demircitaks/proxys/measuring-cup/TOZ-MINI.md

# Mini toz kepçesi — 15 mL / 30 mL

Üç parça, pim yok, O-ring yok, ray yok. Hepsi desteksiz basılır.

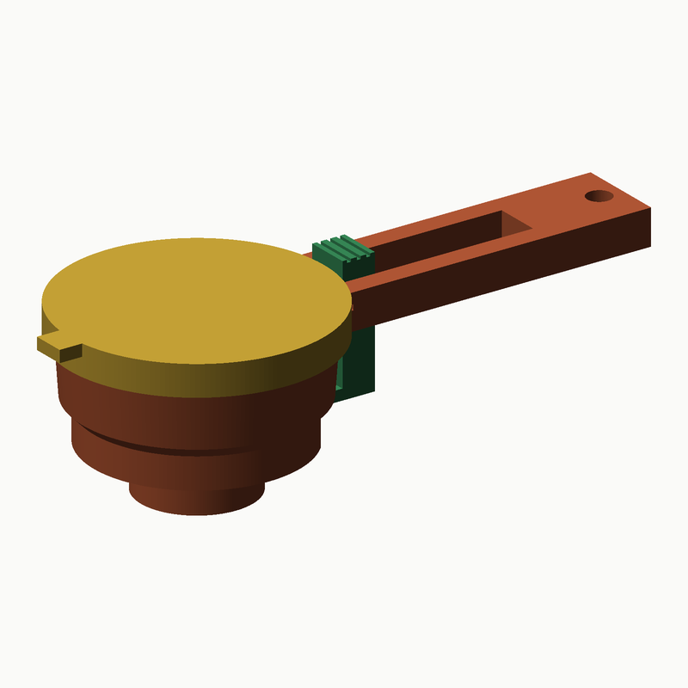
[picture p3: measuring-cup/docs/mini-kepce.png]
Kepçe


| Parça | Ne yapar |
|---|---|
| **Hazne** | Yuvarlak; üst kısmı 7° konik, altta **45° huni**, en altta **Ø22 açıklık = tabanın tamamı** (düz taban yok). 15 mL için 15,7 mm, 30 mL için 26,9 mm derin (huni hacim aldığı için). Dışı altta 45° pahlı (hafif huni görünümü). Açıklık, haznenin altındaki ince taban levhasının (alt deri + **sürgü kanalı** + üst deri) içinden geçer ve 45° koniyle **Ø20,6 × 8 mm boruya** iner: boru 500 mL PET su şişesinin boynuna (PCO-1881 iç Ø21,74; hafif 26/22 boyun ~21,4) 0,4–0,6 mm boşlukla **girer**, toz dışarı dökülmez. **Sap ağız hizasında**, cidara bağlı; 58 mm, asma delikli; kökünde sürgü ayağının geçtiği çatal yarığı. |
| **Sürgü** (taban plakası) | Kanalda kayan **deliksiz** plaka + arkaya uzanan kol + haznenin dışında dik yükselen **ayak** + sapın üstünde tırtıklı **başparmak sürgüsü**. Kapalıyken plaka açıklığın altında, yay parmakları kanal duvarındaki yuvaya oturur (klik); sürgüyü **29 mm kendine çek** → açıklık tamamen açılır, ayak çatalın sonuna dayanır; ileri it → klik, kapalı. Ayak boyu hazneye göre (15/30 ayrı). |
| **Üst kapak** | Ağza klik diye geçen düz kapak, kulaklı; eteği sap hizasında kesik (klik 320°'de). |

**Kullanım:** üst kapağı çıkar → daldır, sıyır → kapağı tak. Dökerken: kepçeyi
şişe ağzına oturt (havşa ağzı ortalar), sapı tutan elin başparmağıyla sürgüyü
kendine çek, hafifçe tıklat, sürgüyü ileri it.

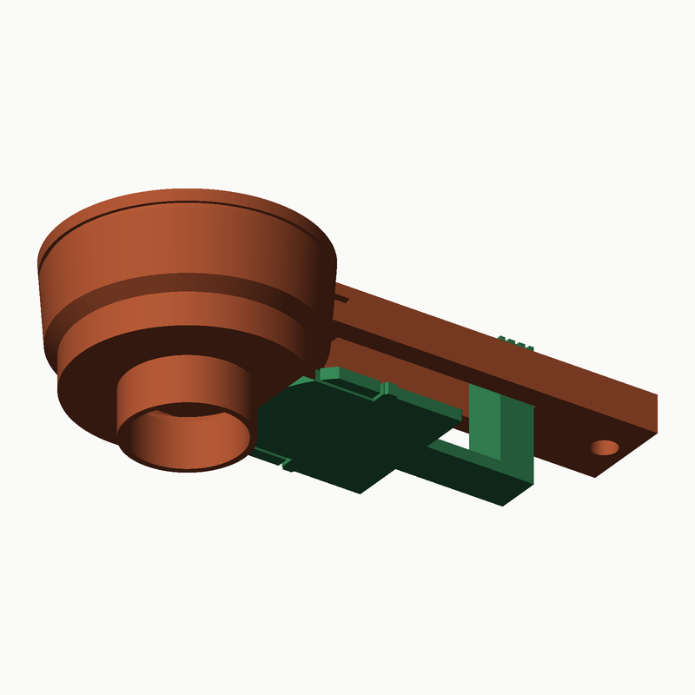
[picture p4: measuring-cup/docs/mini-acik-alt.png]
Açık, alttan


## Ölçülen

| | 15 mL | 30 mL |
|---|---|---|
| Sürgü 0–29 mm kayarken hazneyle girişim (tümseksiz) | 0,000 mm³ | 0,000 mm³ |
| Yay parmağı tümseklerinin kanal duvarına binmesi (arada, esneme 0,35 mm) | 2,41 mm³ | 2,41 mm³ |
| Kapalı / açık konumda, üst kapak takılı, kapak–sürgü | 0 / 0 / 0 / 0 | 0 / 0 / 0 / 0 |
| Kapalıyken açıklık plaka ile tam örtülü; açıkken plaka açıklığın üstünde değil | evet / evet | evet / evet |
| İç hacim (ağza kadar, mesh) | 14,997 mL | 29,992 mL |
| Silme hacim | 15,0000 mL | 30,0000 mL |

## Parçalar ve baskı

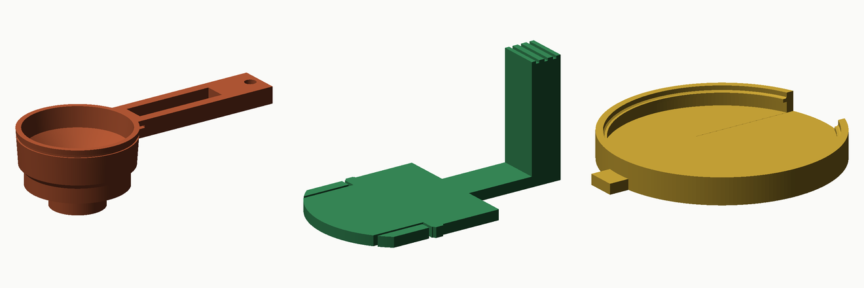
[picture p5: measuring-cup/docs/mini-parcalar.png]
Parçalar


`stl/toz-mini/` dosyaları **model yönünde** (sap üstte, kullanıldığı gibi).
`stl/toz-mini/baski/` aynı parçalar **baskı yönünde** (çevrilmiş) — dilimleyiciye
doğrudan bunları atabilirsin.

| Dosya | Baskı yönü |
|---|---|
| `01-hazne-15ml.stl` · `01-hazne-30ml.stl` | 180° çevir: **ağız tablada**, sap tablada, huni yukarı. İç huni ve dış pah 45° → destek yok |
| `02-surgu-15ml.stl` · `-30ml.stl` | Olduğu gibi: plaka tablada, ayak dik yukarı |
| `03-ust-kapak-15ml.stl` · `-30ml.stl` | 180° çevir: dış yüzü tablada, etek yukarı |

PETG · 0,16 mm · 3 duvar · %15 dolgu · destek kapalı. Tek köprü: haznenin iç
tabanı sürgü kanalının üstünde 28 mm köprülenir (X1C için sorun değil).
Ayrıntı: `BASKI-KILAVUZU.pdf`. Sürgü sıkıysa `FIT` 0,30 → 0,40; klik zayıfsa
`BUMP` 0,5 → 0,6; huni daha dik istenirse `FUN_A` 45 → 55 (`cad/scoop_mini.py`).

## Hazır baskı dosyaları (Bambu Lab X1C)

`x1c/` klasörü:

| Dosya | Ne için |
|---|---|
| `kepce-15ml-X1C.gcode.3mf` · `kepce-30ml-X1C.gcode.3mf` | **Dilimlenmiş**, doğrudan basılır. USB belleğe at → yazıcı ekranında seç → bas. Ya da Bambu Studio'da *Dosya → İçe aktar* ile aç ve Wi-Fi/bulut üzerinden gönder. |
| `kepce-15ml-proje.3mf` · `kepce-30ml-proje.3mf` | Dilimlenmemiş **proje**: Bambu Studio / OrcaSlicer'da aç, istersen ayarları değiştir, dilimle, gönder. |
| `profil/` | Kullanılan X1C profilleri (0,4 nozul; 0,16 mm; Bambu PETG HF; 3 duvar; %15 gyroid; destek kapalı; brim yok; **Textured PEI tabla 70 °C**, nozul 245 °C). |

Tek plakada hazne + sürgü + üst kapak: 15 mL ≈ **57 dk, 21,5 g**; 30 mL ≈ **70 dk, 26,8 g**.
Yazıcıda *Textured PEI* plaka takılı olmalı; filament AMS'te PETG (HF) olarak tanımlı
olmalı. Yeniden üretim: `cad/slice_x1c.sh` (OrcaSlicer CLI).

## Montaj

1. Sürgünün ayağını sapın kökündeki çatal yarığına üstten sokun, plakayı
   haznenin altındaki kanala arkadan sürüp öne itin; sonunda klik (kapalı).
2. Sürgüyü geri çekin: ayak çatalın sonuna dayanınca açıklık tamamen açık.
   Üst kapağı bastırın (eteğin kesik tarafı sapa gelir).
3. Temizlik: sürgüyü arkaya çekip ayağı çataldan yukarı çıkarın.

## Notlar

- Hacim ölçer, gram değil: 15 mL ≈ 5–8 g, 30 mL ≈ 10–17 g. Bir kez tartın.
- Açıklık Ø22, huni 45°, boru içi Ø18,4: toz kendi ağırlığıyla akar, gerekirse
  tıklatın. Düz taban olmadığı için köşede toz kalmaz.
- Boru altta 8 mm çıkıntı yaptığı için kepçe masaya düz oturmaz; kutunun
  içinde veya kapağının üstünde durur. Boru sığmayan (iç çapı < 20,8) boyun
  görürsen `SPOUT_OD` 20,6 → 20,0.
- Plaka ile üst deri arası düz-düz temas (0,3 mm boşluk); toz için yeterli,
  sıvı için değil. Kapalıyken plakada delik yok: çantada dökülmez.
- FDM gıda sertifikasız; elde yıkayın.

`python3 cad/build_mini.py` → STL (`stl/toz-mini/`), rapor, görseller.
