demircitaks/proxys/measuring-cup/docs/kesit-15ml.png

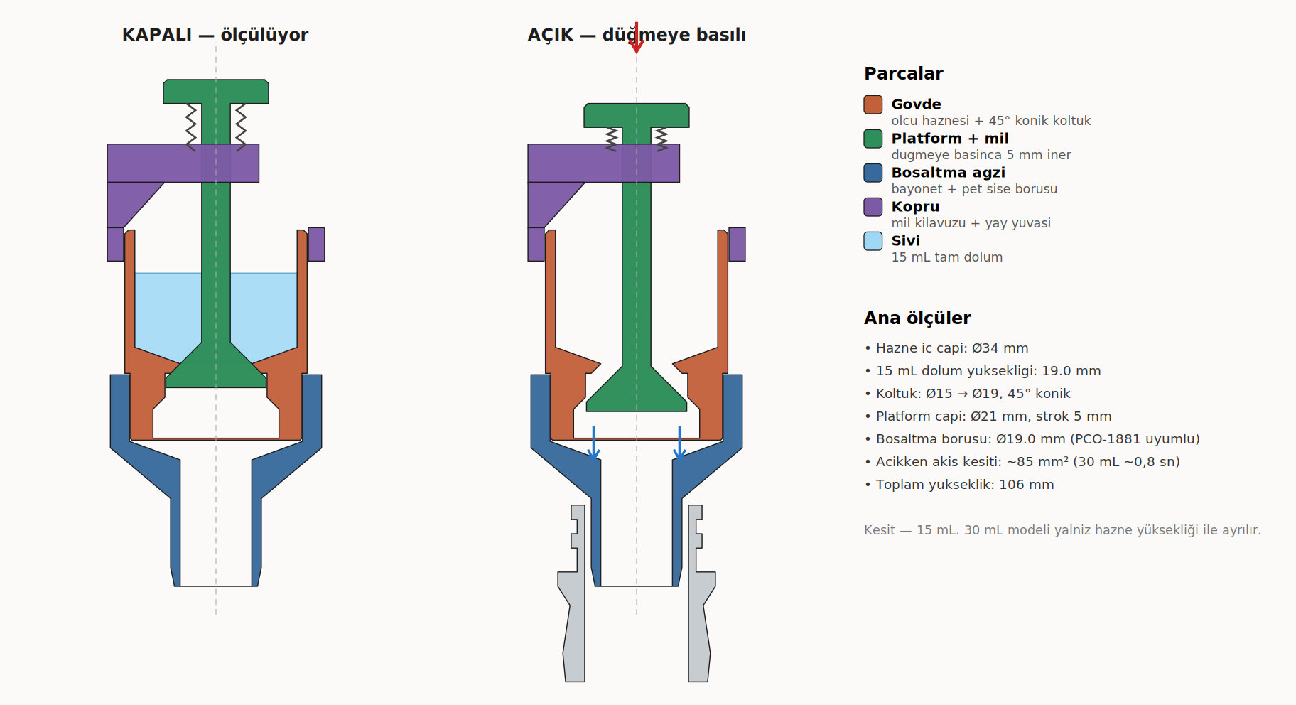
measuring-cup/docs/kesit-15ml.png
