demircitaks/proxys/measuring-cup/docs/kesit-30ml.png

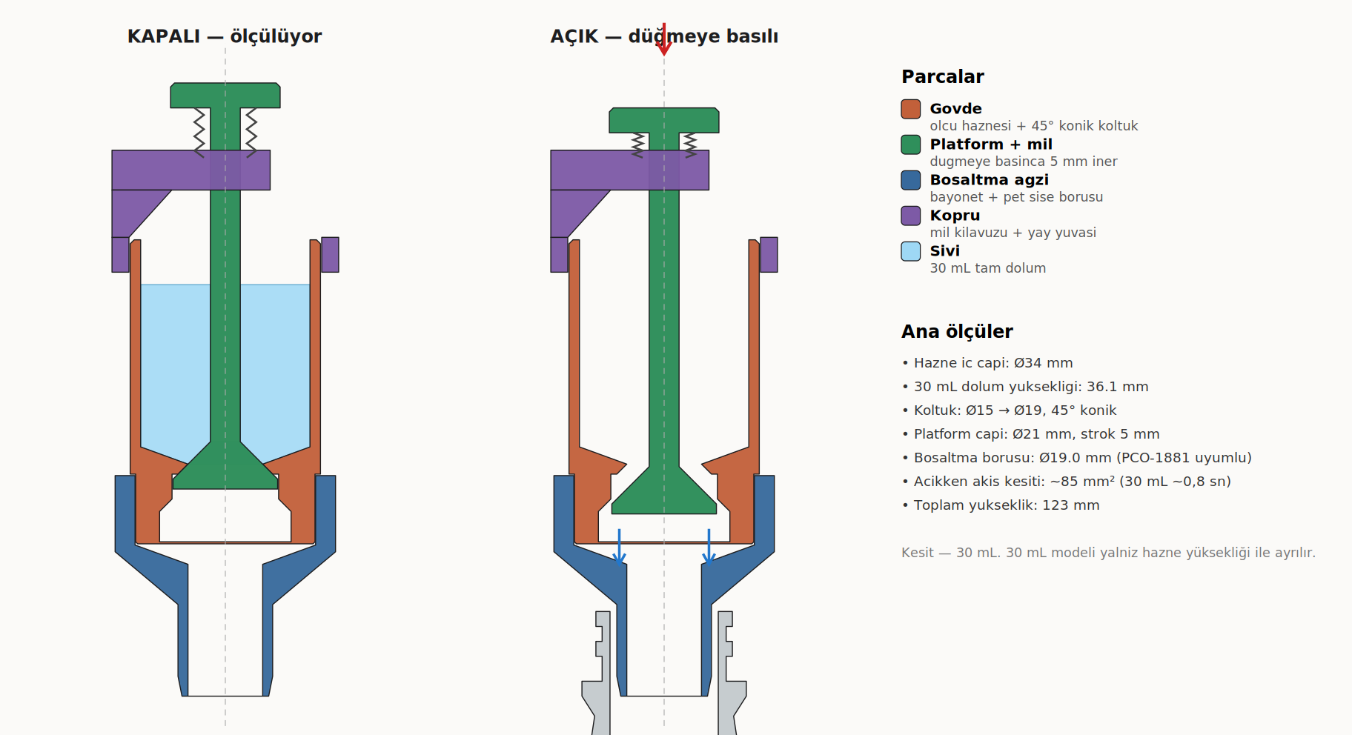
measuring-cup/docs/kesit-30ml.png
