demircitaks/proxys/measuring-cup/docs/mini-15ml-acik.png

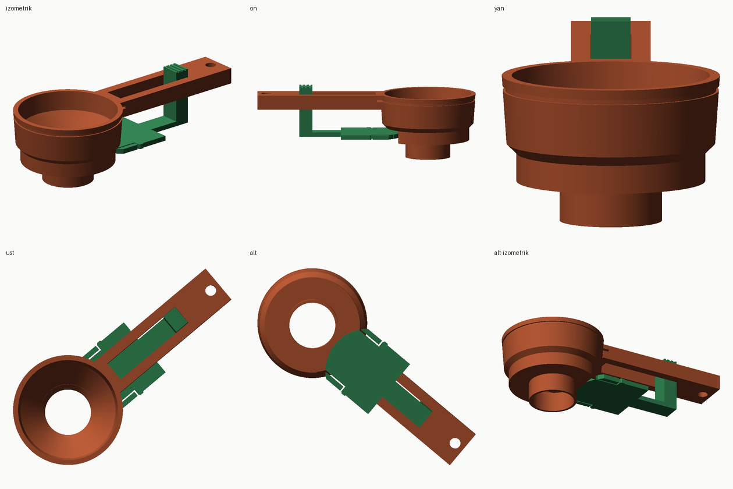
measuring-cup/docs/mini-15ml-acik.png
