demircitaks/proxys/measuring-cup/docs/mini-kesit.png

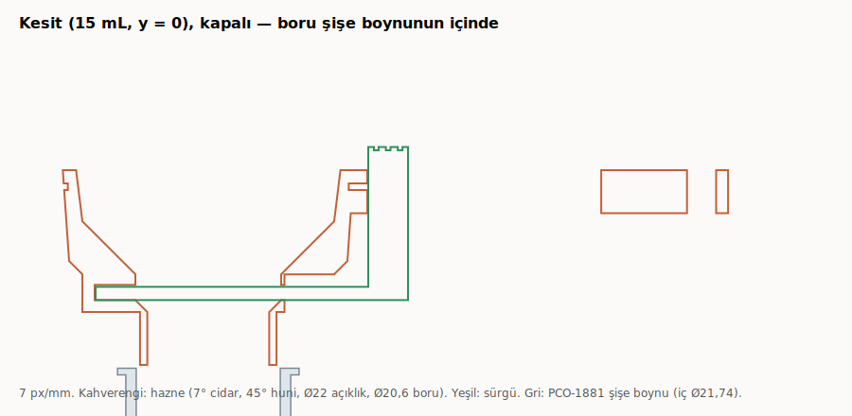
measuring-cup/docs/mini-kesit.png
