demircitaks/proxys/measuring-cup/docs/sade-15ml-acik.png

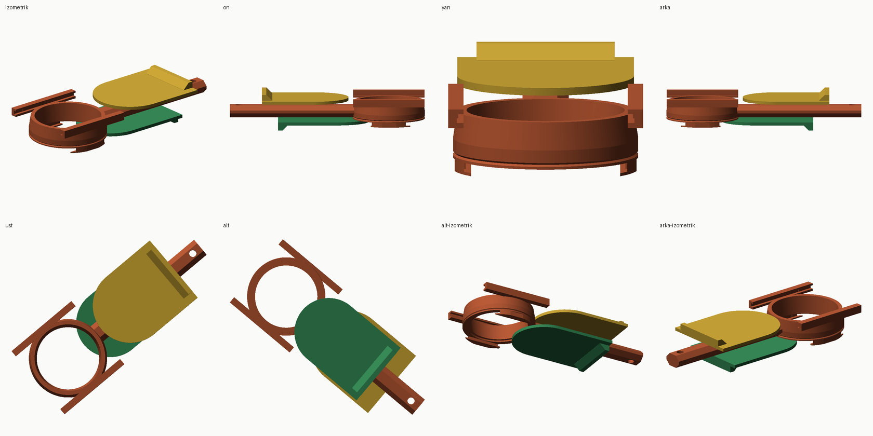
measuring-cup/docs/sade-15ml-acik.png
