demircitaks/proxys/measuring-cup/docs/sade-15ml-kapali.png

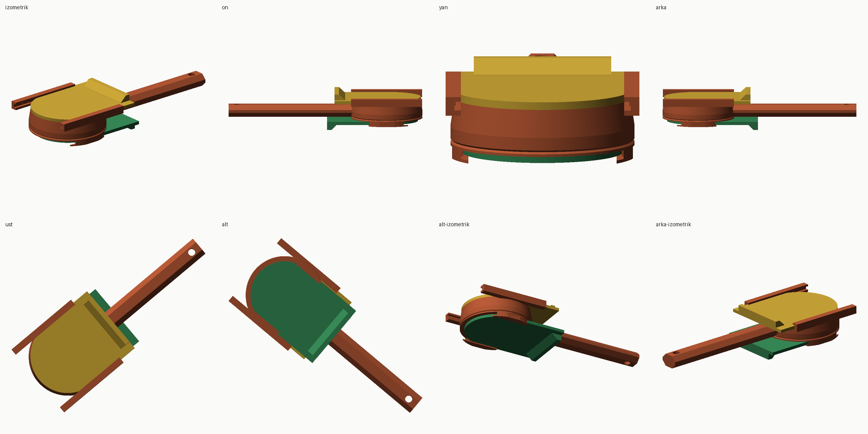
measuring-cup/docs/sade-15ml-kapali.png
