demircitaks/proxys/measuring-cup/docs/sade-30ml-kapali.png

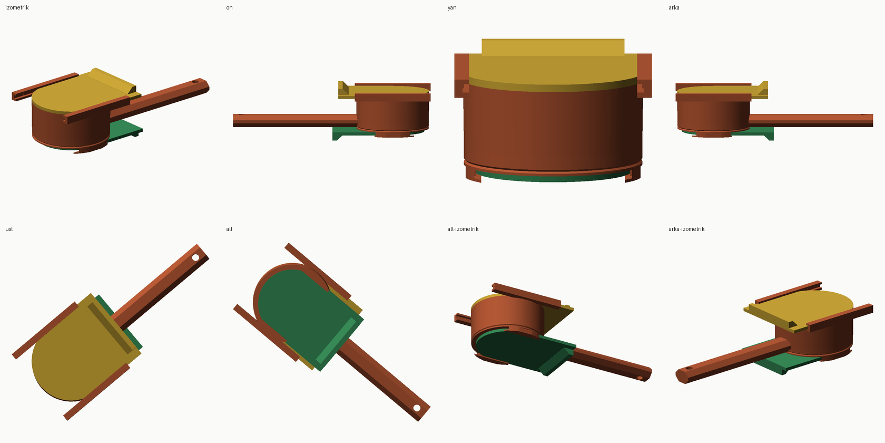
measuring-cup/docs/sade-30ml-kapali.png
