demircitaks/proxys/measuring-cup/docs/surgulu-15ml-acik.png

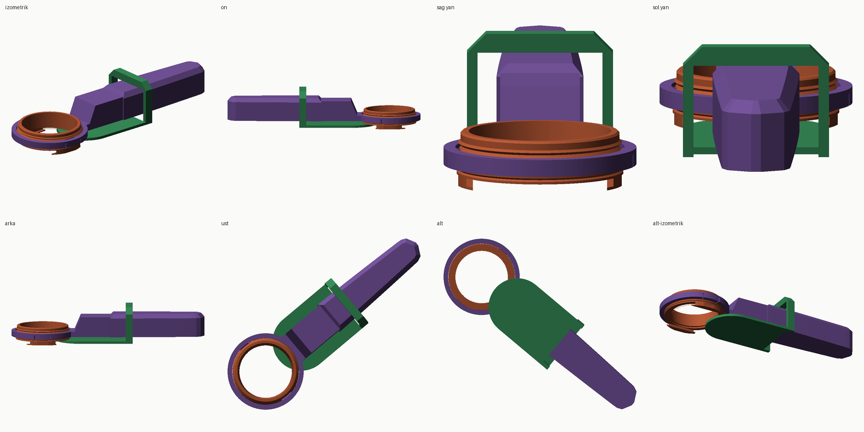
measuring-cup/docs/surgulu-15ml-acik.png
