demircitaks/proxys/measuring-cup/docs/surgulu-huni.png

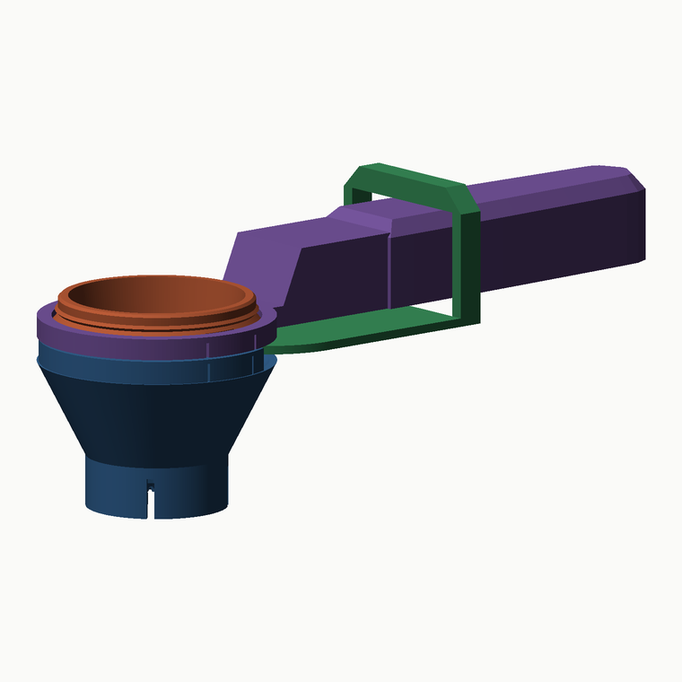
measuring-cup/docs/surgulu-huni.png
