demircitaks/proxys/measuring-cup/docs/surgulu-oring.png

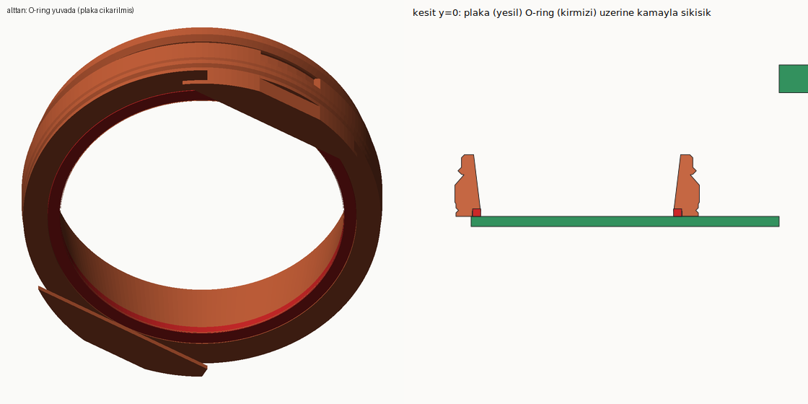
measuring-cup/docs/surgulu-oring.png
