demircitaks/proxys/measuring-cup/docs/toz-kesit-15ml.png

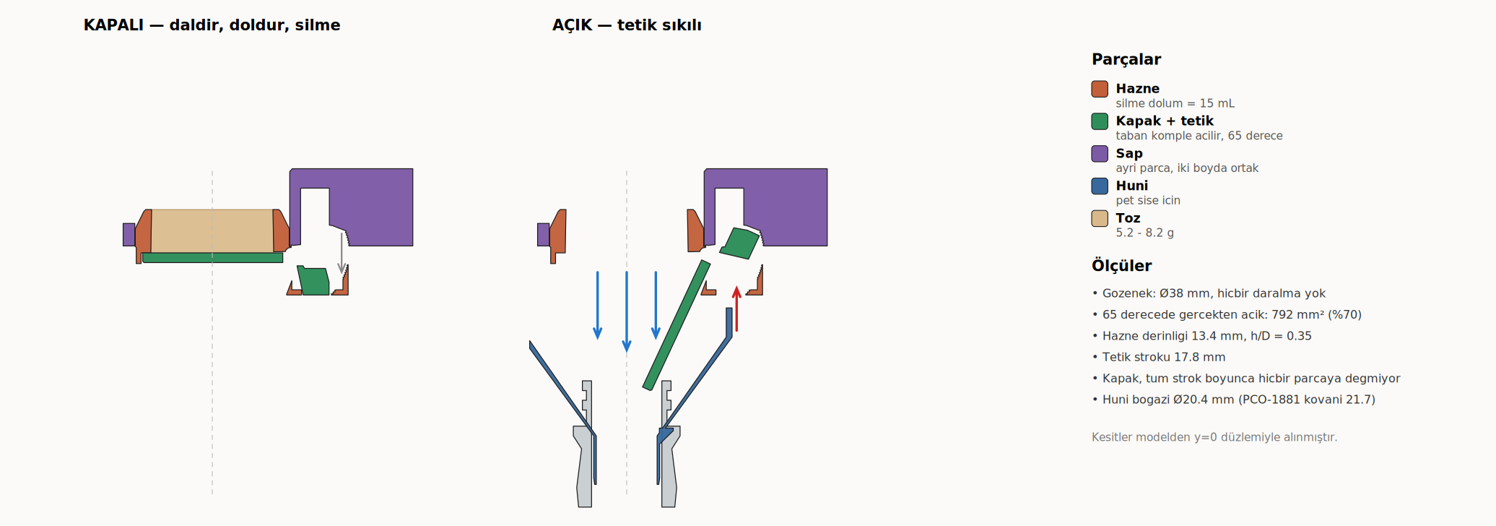
measuring-cup/docs/toz-kesit-15ml.png
