demircitaks/proxys/measuring-cup/docs/toz-olcegi-acik.png

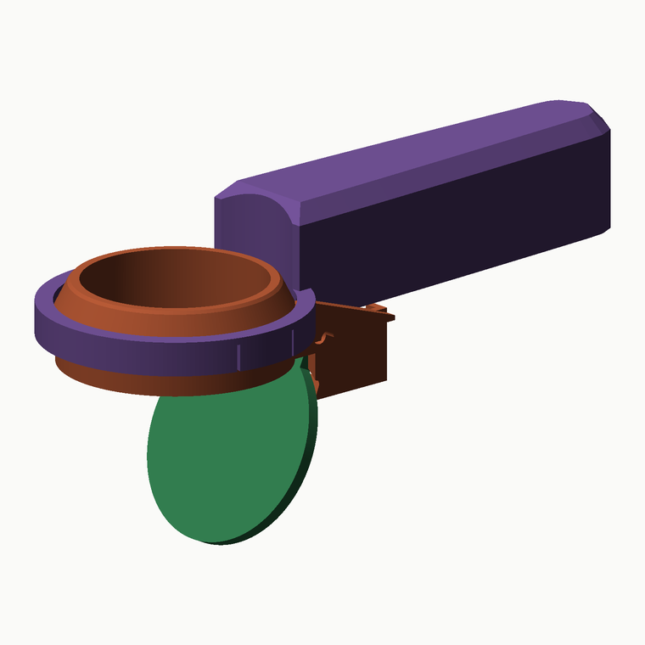
measuring-cup/docs/toz-olcegi-acik.png
