demircitaks/proxys/measuring-cup/docs/toz-olcegi-kapali.png

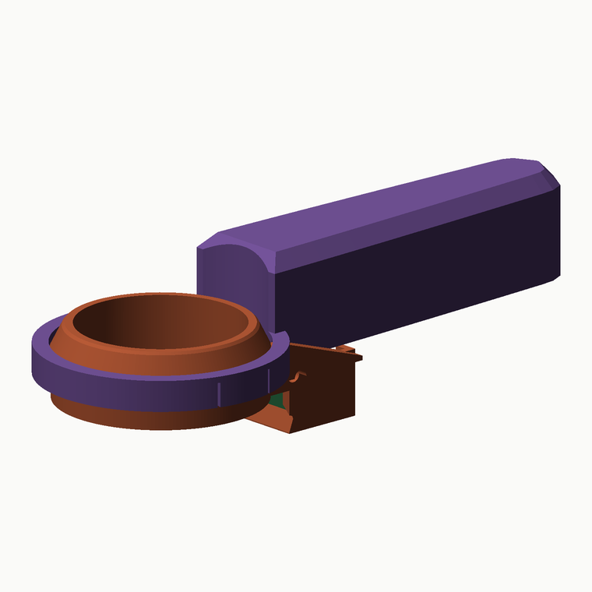
measuring-cup/docs/toz-olcegi-kapali.png
