demircitaks/proxys/measuring-cup/docs/x1c-plate-15-small.png

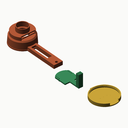
measuring-cup/docs/x1c-plate-15-small.png
