demircitaks/proxys/measuring-cup/docs/x1c-top-15.png

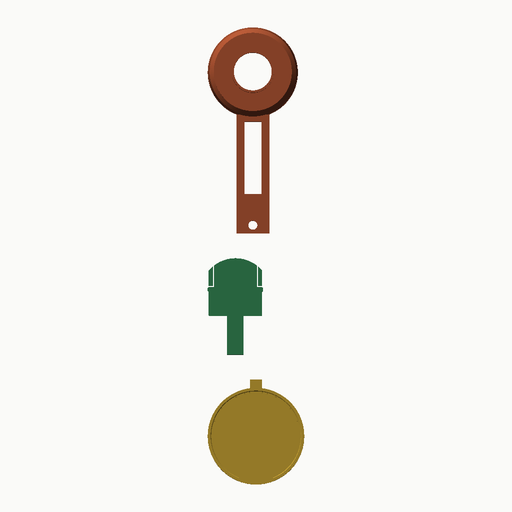
measuring-cup/docs/x1c-top-15.png
