demircitaks/proxys/measuring-cup/docs/yuvarlak-15ml-acik.png

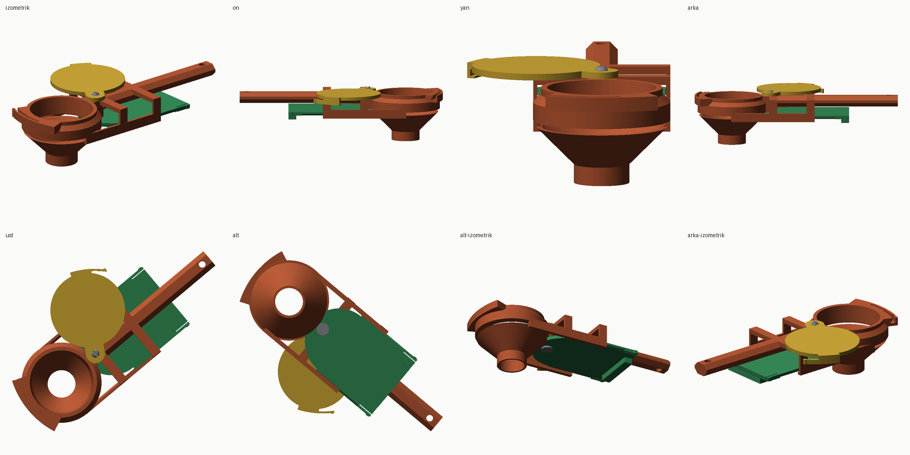
measuring-cup/docs/yuvarlak-15ml-acik.png
