demircitaks/proxys/measuring-cup/docs/yuvarlak-30ml-kapali.png

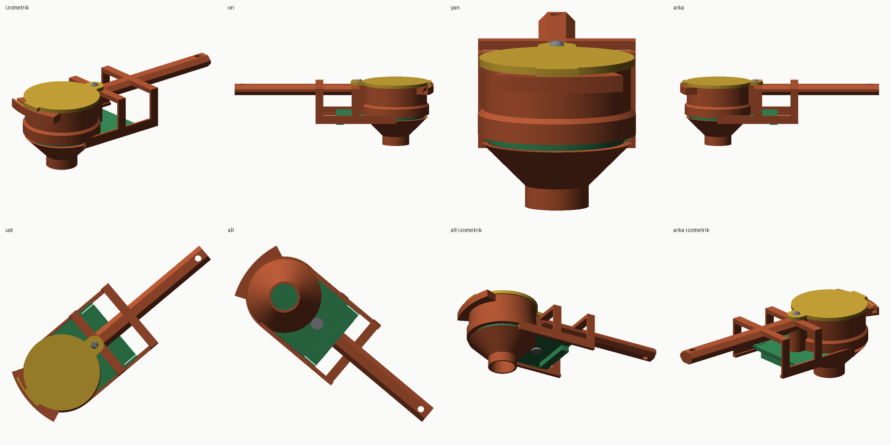
measuring-cup/docs/yuvarlak-30ml-kapali.png
