demircitaks/proxys/measuring-cup/stl/02-platform-mil-15ml.stl

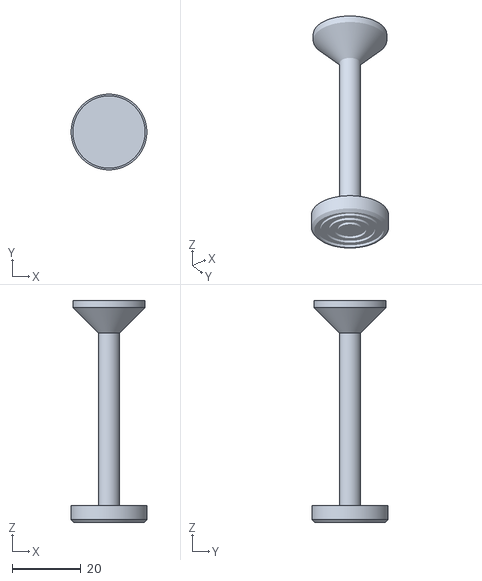
[picture p35: CAD file, 2026-09-24]
measuring-cup/stl/02-platform-mil-15ml.stl
22.0 x 22.0 x 64.5
