demircitaks/proxys/measuring-cup/stl/toz-mini/01-hazne-15ml.stl

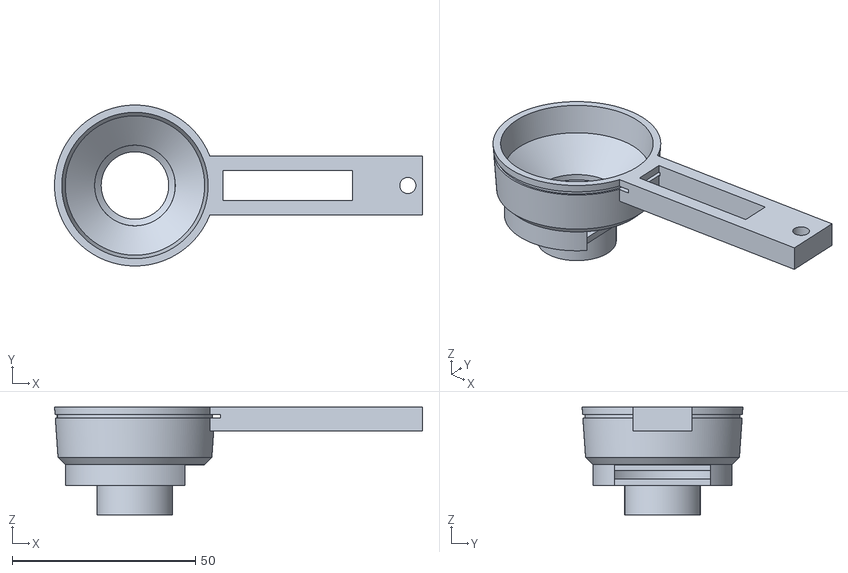
[picture p36: CAD file, 2026-10-03]
measuring-cup/stl/toz-mini/01-hazne-15ml.stl
100.4 x 43.9 x 29.4
