demircitaks/proxys/measuring-cup/stl/toz-mini/baski/01-hazne-30ml.stl

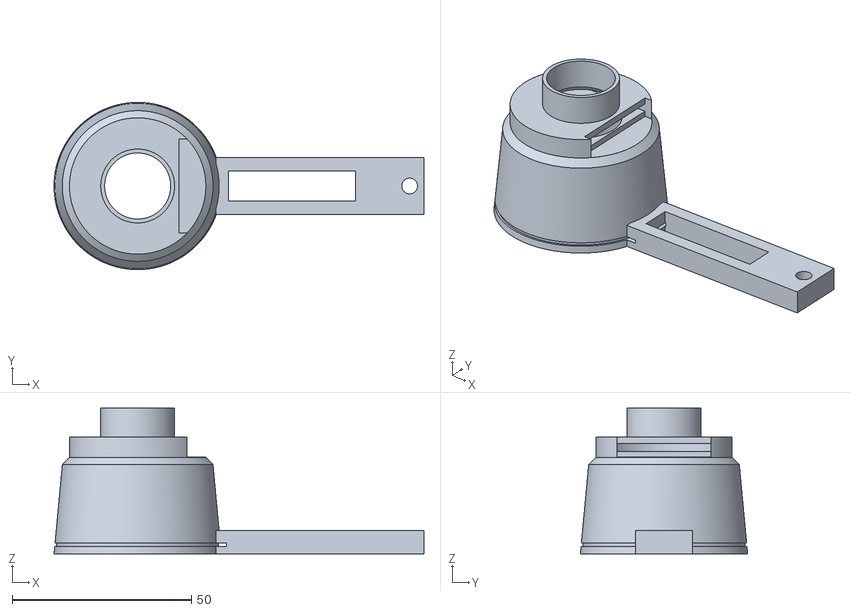
[picture p37: CAD file, 2026-10-03]
measuring-cup/stl/toz-mini/baski/01-hazne-30ml.stl
103.2 x 46.7 x 40.6
