demircitaks/proxys/measuring-cup/stl/toz-surgulu/01-hazne-15ml.stl

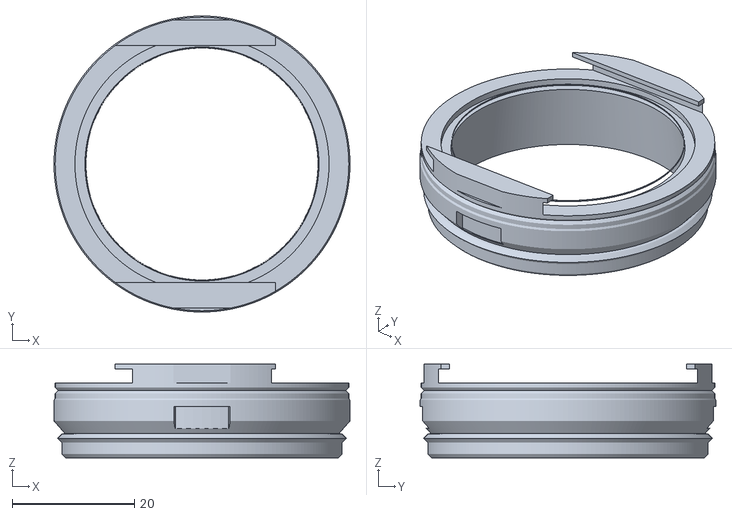
[picture p38: CAD file, 2026-09-24]
measuring-cup/stl/toz-surgulu/01-hazne-15ml.stl
48.4 x 48.4 x 15.3
