demircitaks/proxys/measuring-cup/stl/toz-yuvarlak/01-hazne-30ml.stl

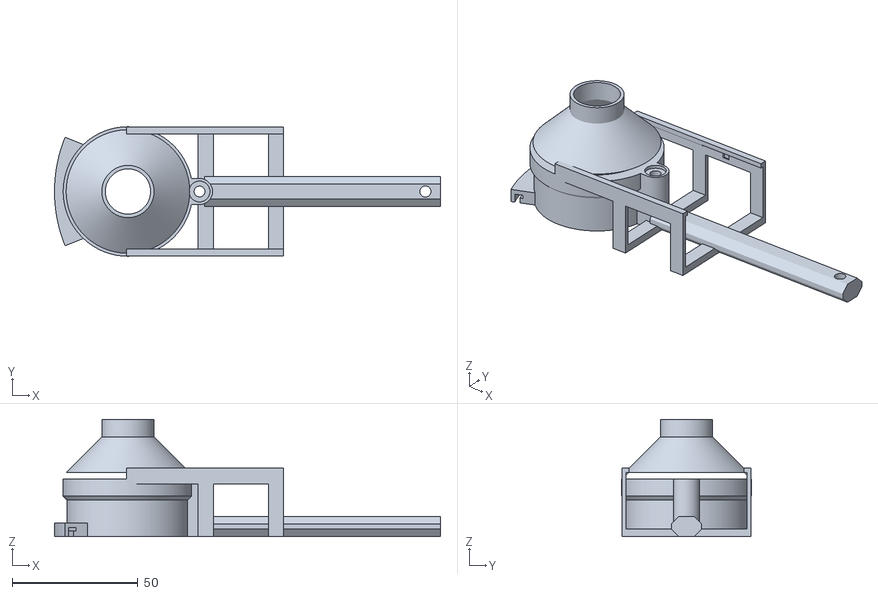
[picture p39: CAD file, 2026-09-25]
measuring-cup/stl/toz-yuvarlak/01-hazne-30ml.stl
153.8 x 51.6 x 46.7
