demircitaks/proxys/measuring-cup/x1c/kepce-30ml-proje.3mf

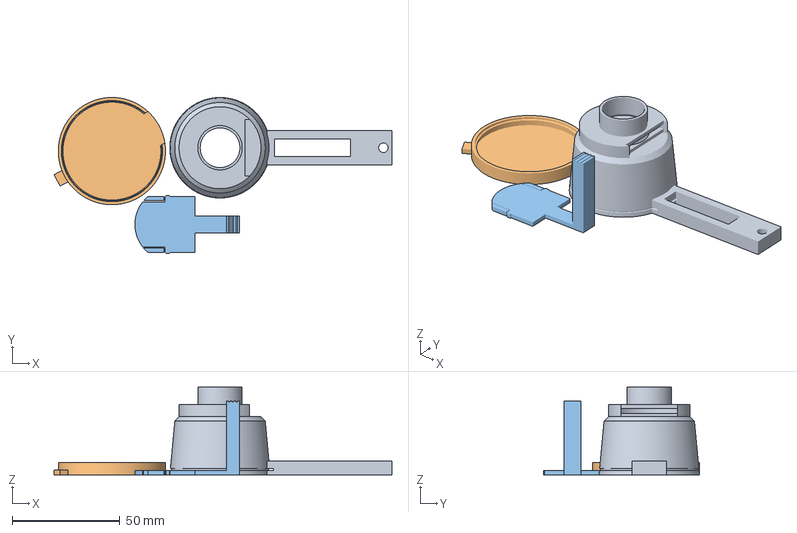
[picture p40: CAD file, 2026-10-03]
measuring-cup/x1c/kepce-30ml-proje.3mf
156.9 x 72.4 x 40.6 mm
01-hazne-30ml.stl
03-ust-kapak-30ml.stl
02-surgu-30ml.stl
