demircitaks/proxys/measuring-cup/stl/03-bosaltma-agzi.stl

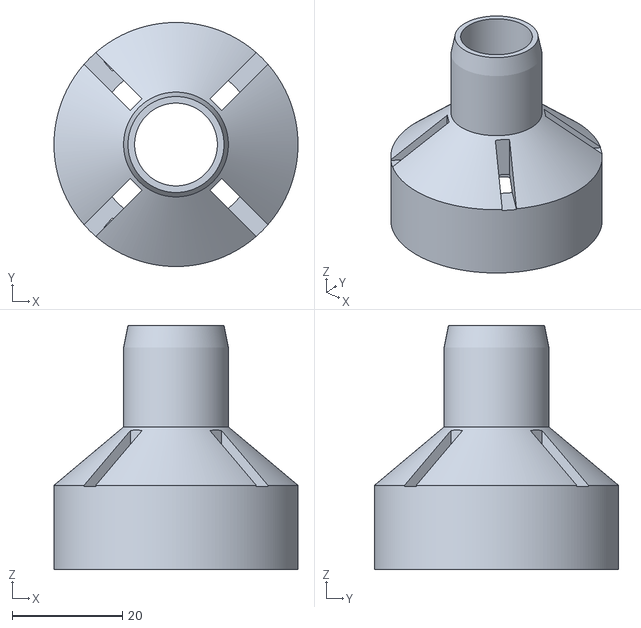
[picture p41: CAD file, 2026-09-24]
measuring-cup/stl/03-bosaltma-agzi.stl
44.2 x 44.2 x 44.3
