demircitaks/proxys/measuring-cup/stl/toz-olcegi/02-kapak-tetik.stl

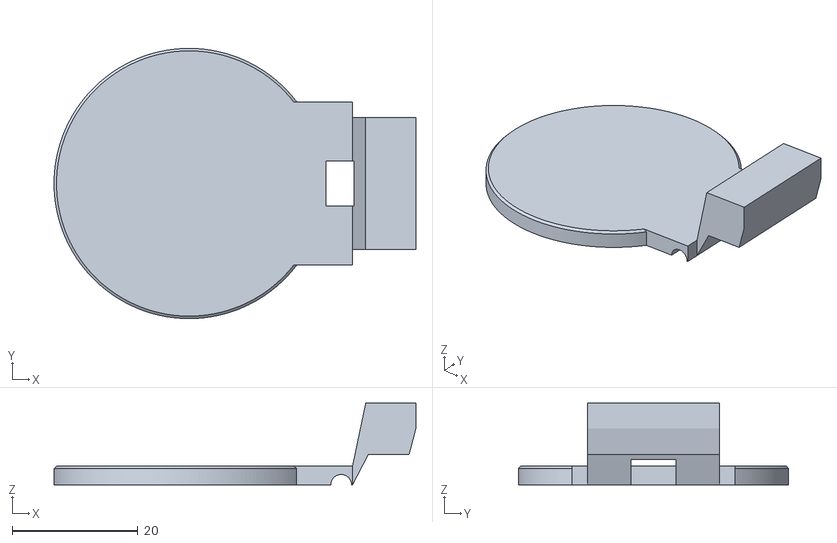
[picture p42: CAD file, 2026-09-24]
measuring-cup/stl/toz-olcegi/02-kapak-tetik.stl
57.6 x 43.0 x 13.0
