demircitaks/proxys/measuring-cup/stl/toz-surgulu/02-surgu.stl

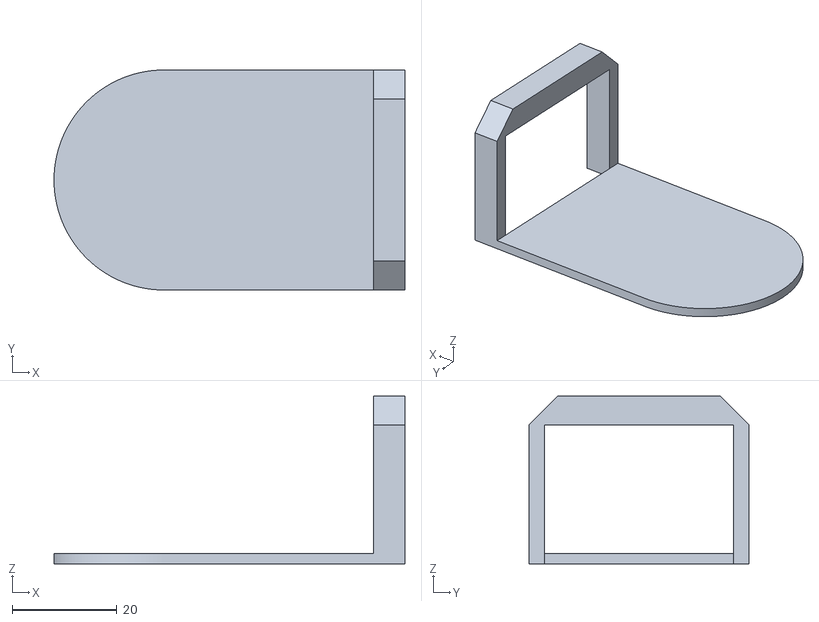
[picture p43: CAD file, 2026-09-24]
measuring-cup/stl/toz-surgulu/02-surgu.stl
67.0 x 42.0 x 32.0
