demircitaks/proxys/measuring-cup/stl/toz-yuvarlak/02-alt-plaka.stl

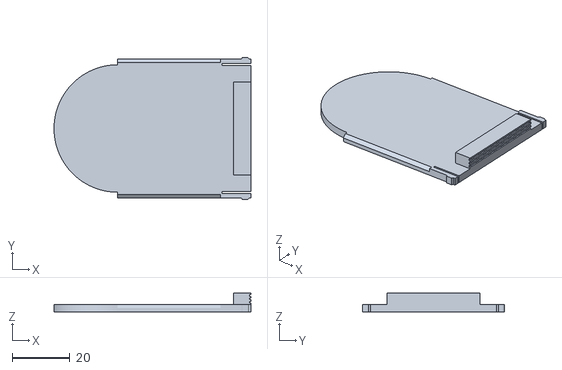
[picture p44: CAD file, 2026-09-25]
measuring-cup/stl/toz-yuvarlak/02-alt-plaka.stl
68.0 x 49.0 x 6.50
