demircitaks/proxys/measuring-cup/stl/02-platform-mil-30ml.stl

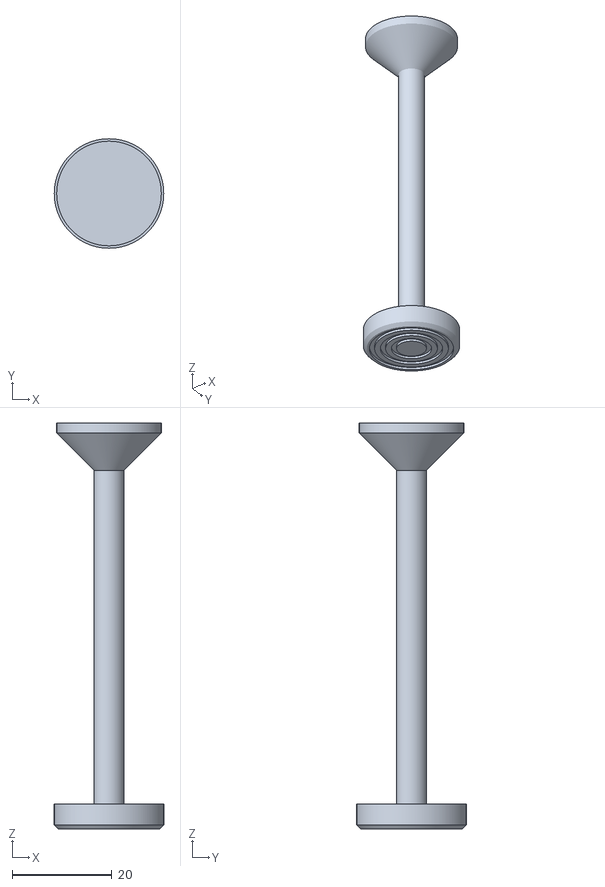
[picture p45: CAD file, 2026-09-24]
measuring-cup/stl/02-platform-mil-30ml.stl
22.0 x 22.0 x 81.6
