demircitaks/proxys/measuring-cup/stl/toz-mini/03-ust-kapak-15ml.stl

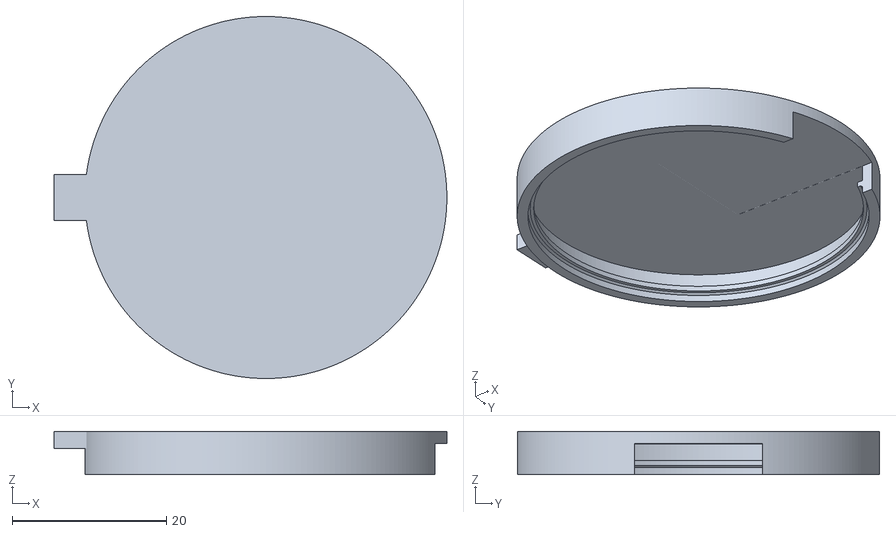
[picture p46: CAD file, 2026-09-27]
measuring-cup/stl/toz-mini/03-ust-kapak-15ml.stl
51.0 x 47.0 x 5.60
