demircitaks/proxys/measuring-cup/stl/toz-mini/baski/02-surgu-30ml.stl

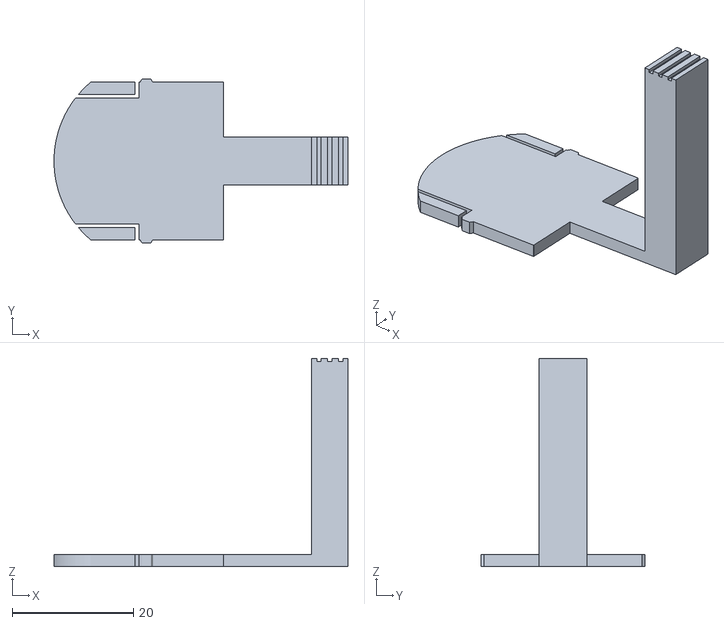
[picture p47: CAD file, 2026-09-27]
measuring-cup/stl/toz-mini/baski/02-surgu-30ml.stl
48.5 x 27.0 x 34.3
