demircitaks/proxys/measuring-cup/stl/toz-surgulu/01-hazne-30ml.stl

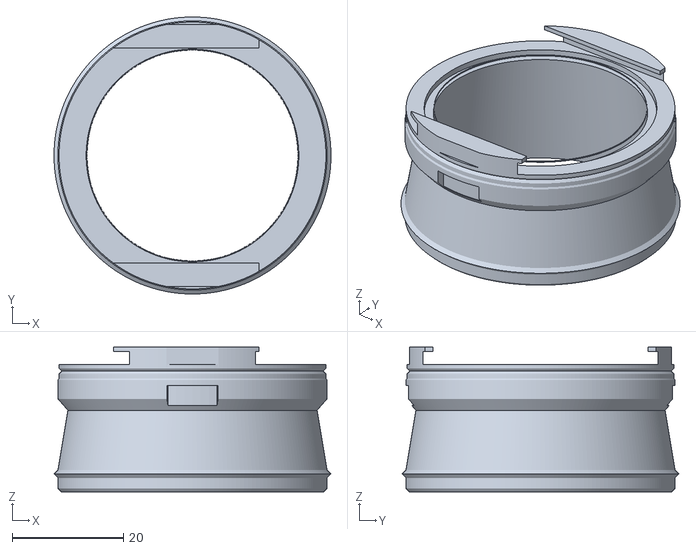
[picture p48: CAD file, 2026-09-24]
measuring-cup/stl/toz-surgulu/01-hazne-30ml.stl
49.8 x 49.8 x 26.0
