demircitaks/proxys/measuring-cup/stl/toz-yuvarlak/01-hazne-15ml.stl

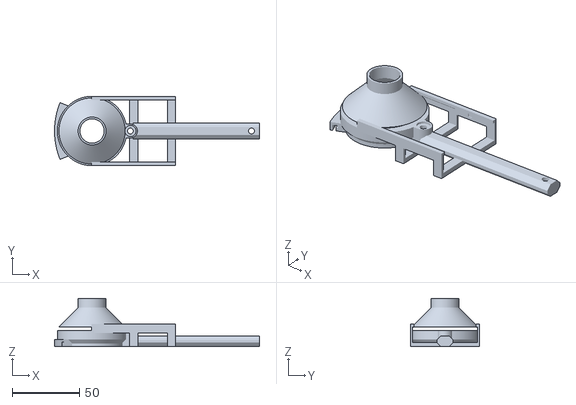
[picture p49: CAD file, 2026-09-25]
measuring-cup/stl/toz-yuvarlak/01-hazne-15ml.stl
152.5 x 51.6 x 36.0
