demircitaks/proxys/measuring-cup/x1c/kepce-15ml-proje.3mf

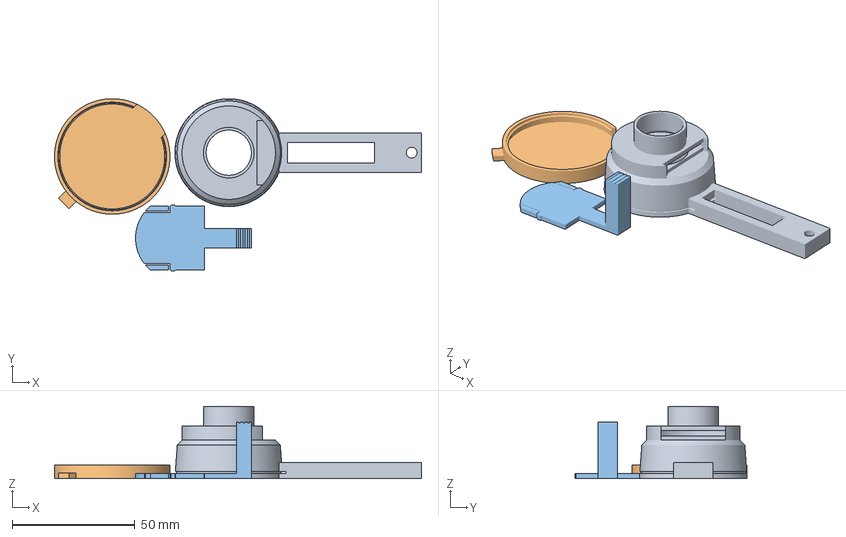
[picture p50: CAD file, 2026-10-03]
measuring-cup/x1c/kepce-15ml-proje.3mf
149.4 x 70.2 x 29.4 mm
01-hazne-15ml.stl
03-ust-kapak-15ml.stl
02-surgu-15ml.stl
