demircitaks/proxys/measuring-cup/stl/01-govde-30ml.stl

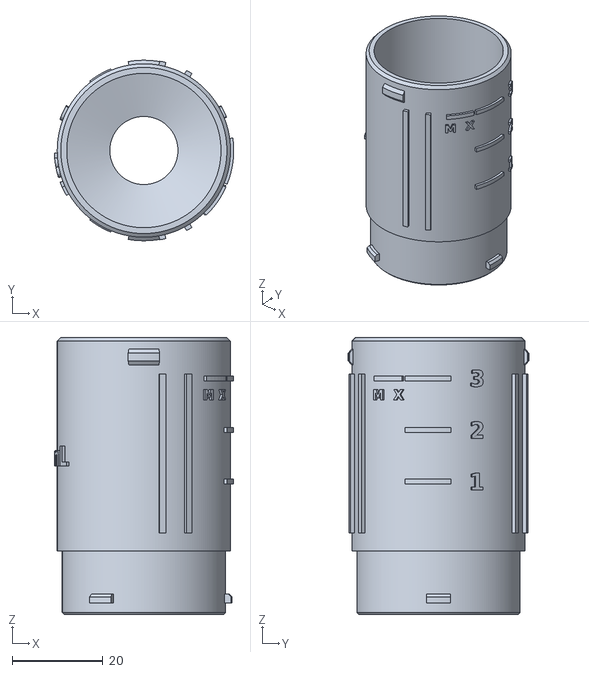
[picture p51: CAD file, 2026-09-24]
measuring-cup/stl/01-govde-30ml.stl
39.5 x 39.8 x 61.1
