demircitaks/proxys/measuring-cup/stl/toz-mini/03-ust-kapak-30ml.stl

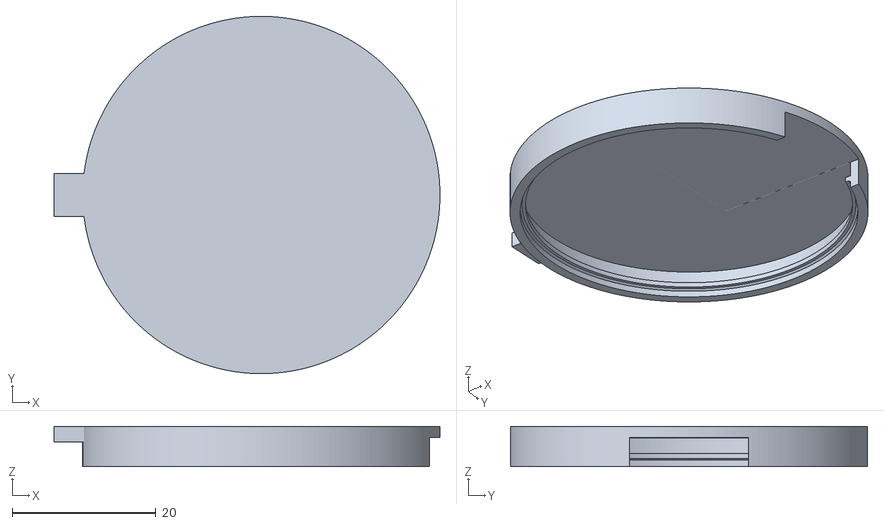
[picture p52: CAD file, 2026-09-27]
measuring-cup/stl/toz-mini/03-ust-kapak-30ml.stl
53.8 x 49.8 x 5.60
