demircitaks/proxys/measuring-cup/stl/toz-surgulu/05-ust-kapak-15ml.stl

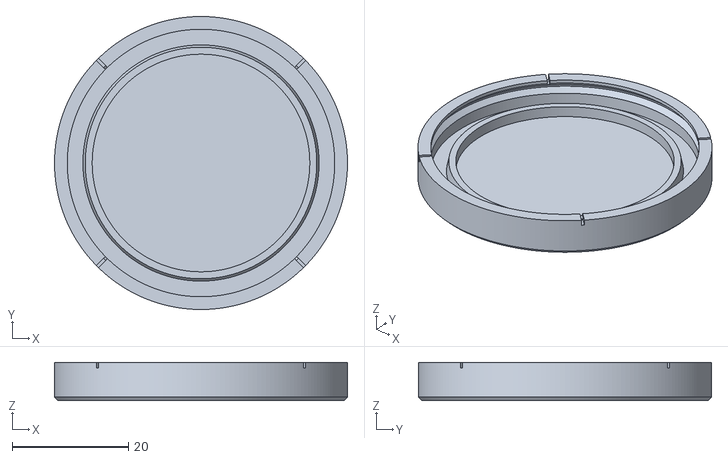
[picture p53: CAD file, 2026-09-24]
measuring-cup/stl/toz-surgulu/05-ust-kapak-15ml.stl
50.5 x 50.5 x 6.60
