demircitaks/proxys/measuring-cup/stl/toz-yuvarlak/05-conta-tpu.stl

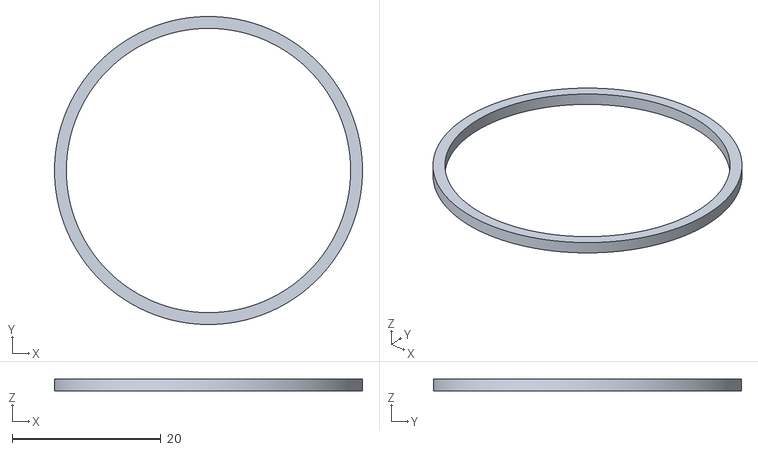
[picture p54: CAD file, 2026-09-25]
measuring-cup/stl/toz-yuvarlak/05-conta-tpu.stl
41.4 x 41.4 x 1.60
