demircitaks/proxys/measuring-cup/stl/05-yay-baskili.stl

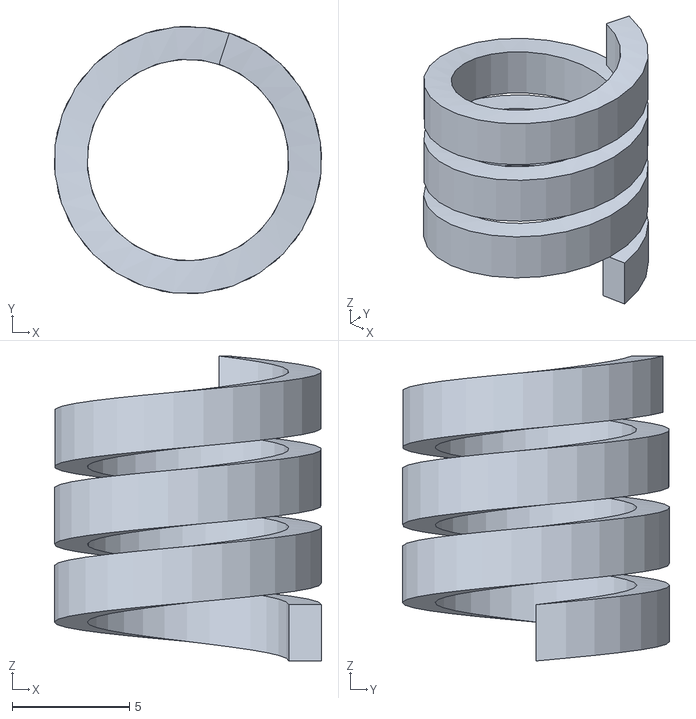
[picture p55: CAD file, 2026-09-24]
measuring-cup/stl/05-yay-baskili.stl
11.4 x 11.4 x 13.0
