demircitaks/proxys/measuring-cup/stl/toz-olcegi/05-mentese-mili.stl

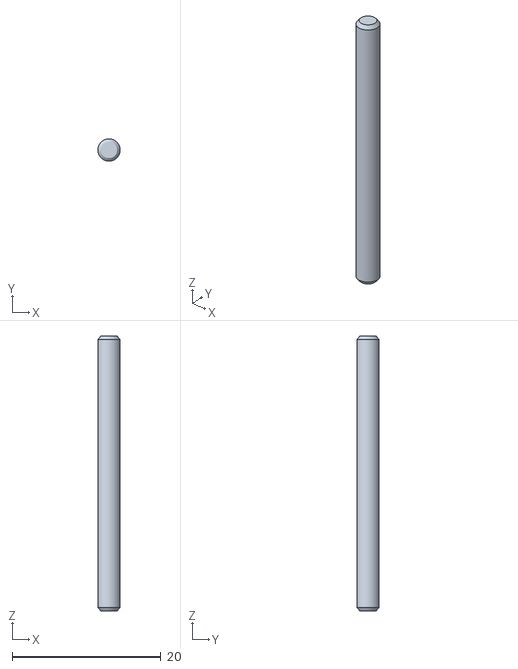
[picture p56: CAD file, 2026-09-24]
measuring-cup/stl/toz-olcegi/05-mentese-mili.stl
3.00 x 3.00 x 37.0
