demircitaks/proxys/measuring-cup/stl/toz-sade/02-alt-plaka.stl

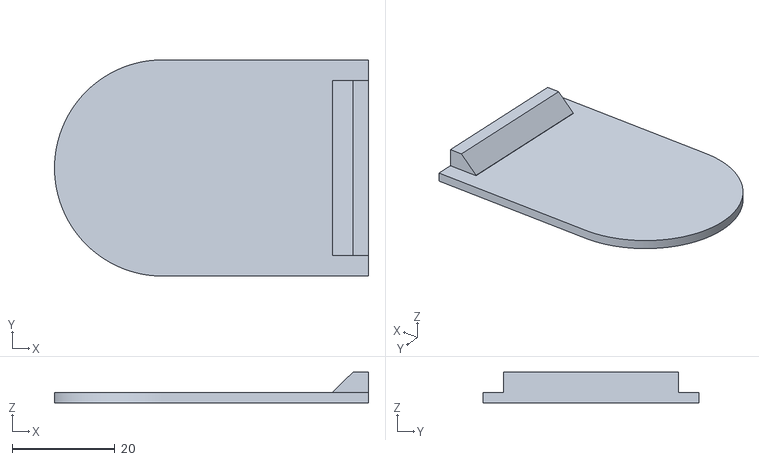
[picture p57: CAD file, 2026-09-24]
measuring-cup/stl/toz-sade/02-alt-plaka.stl
61.0 x 42.0 x 6.00
