demircitaks/proxys/measuring-cup/stl/toz-surgulu/03-sap.stl

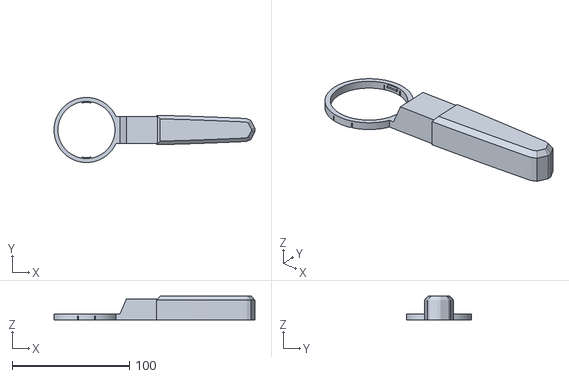
[picture p58: CAD file, 2026-09-24]
measuring-cup/stl/toz-surgulu/03-sap.stl
171.8 x 55.5 x 20.3
