demircitaks/proxys/measuring-cup/stl/toz-yuvarlak/03-ust-disk-30ml.stl

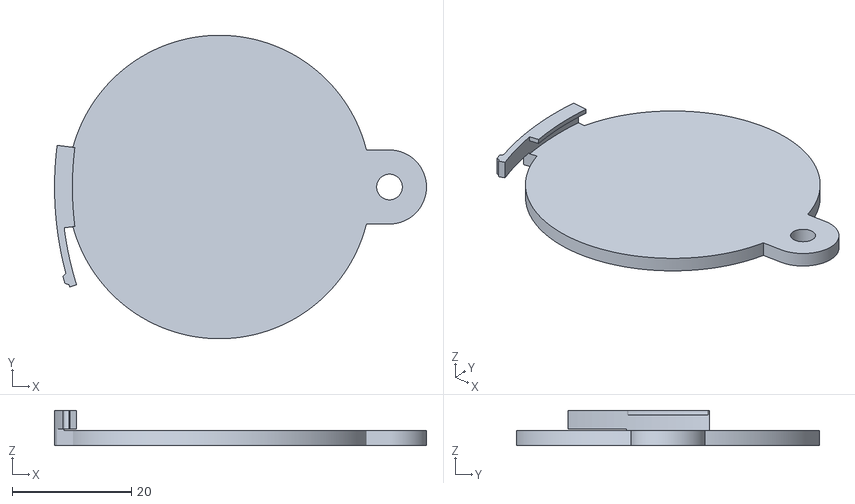
[picture p59: CAD file, 2026-09-25]
measuring-cup/stl/toz-yuvarlak/03-ust-disk-30ml.stl
62.3 x 50.8 x 5.90
