demircitaks/proxys/measuring-cup/stl/06-altlik.stl

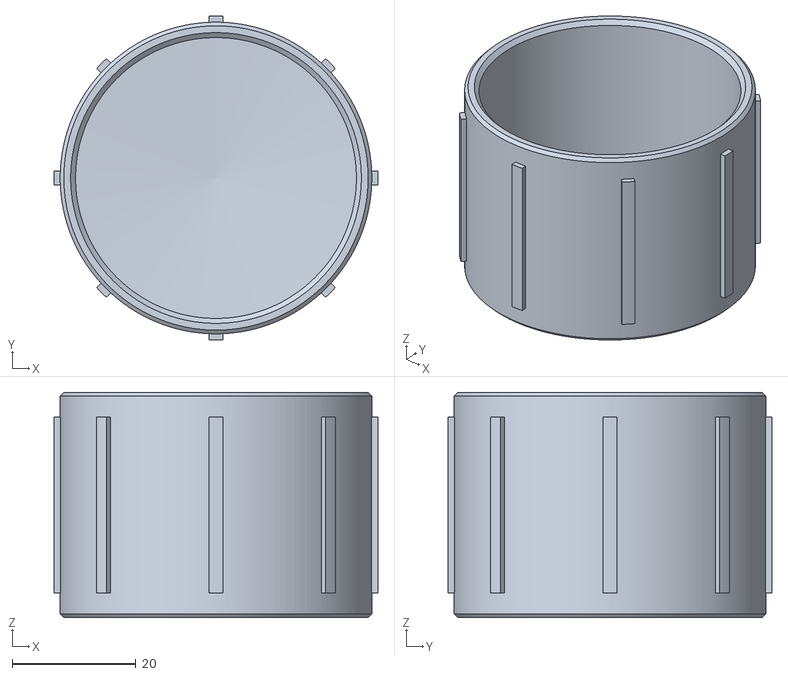
[picture p60: CAD file, 2026-09-24]
measuring-cup/stl/06-altlik.stl
52.4 x 52.4 x 36.5
