demircitaks/proxys/measuring-cup/stl/toz-mini/baski/02-surgu-15ml.stl

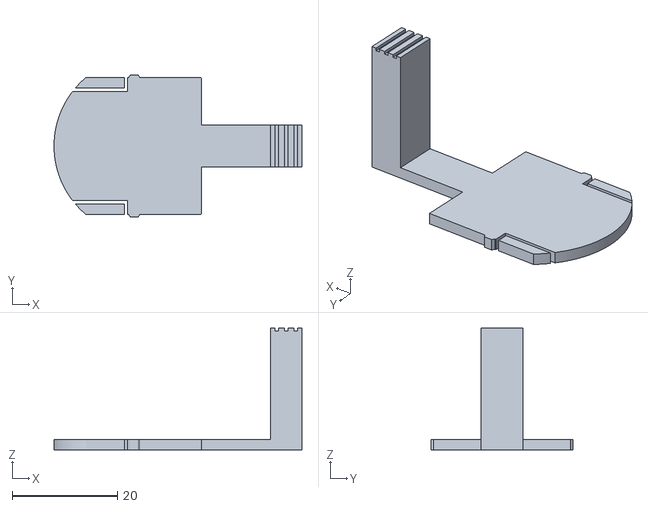
[picture p61: CAD file, 2026-09-27]
measuring-cup/stl/toz-mini/baski/02-surgu-15ml.stl
47.1 x 27.0 x 23.1
