demircitaks/proxys/measuring-cup/stl/toz-sade/04-huni-pet-vidali.stl

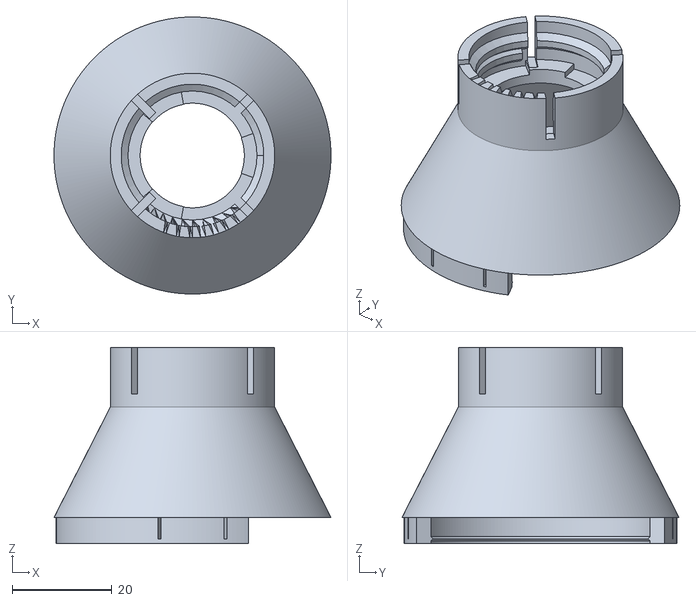
[picture p62: CAD file, 2026-09-24]
measuring-cup/stl/toz-sade/04-huni-pet-vidali.stl
55.6 x 55.6 x 39.4
