demircitaks/proxys/measuring-cup/stl/toz-surgulu/05-ust-kapak-30ml.stl

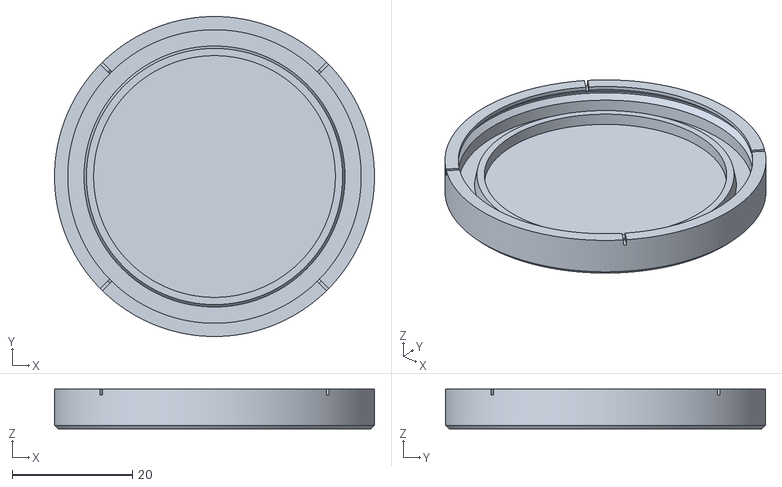
[picture p63: CAD file, 2026-09-24]
measuring-cup/stl/toz-surgulu/05-ust-kapak-30ml.stl
53.1 x 53.1 x 6.60
