demircitaks/proxys/measuring-cup/stl/toz-yuvarlak/03-ust-disk-15ml.stl

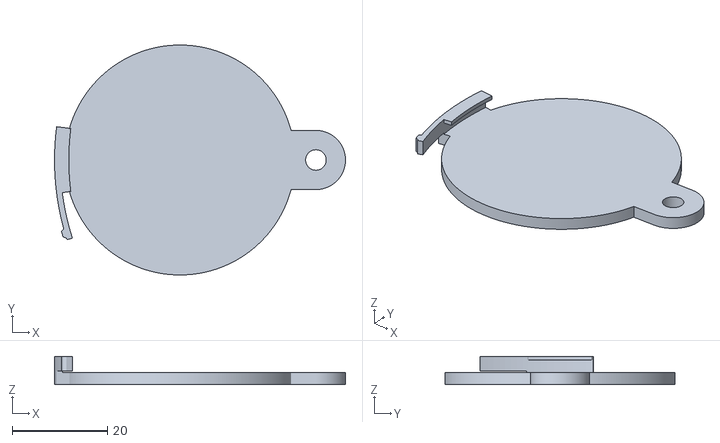
[picture p64: CAD file, 2026-09-25]
measuring-cup/stl/toz-yuvarlak/03-ust-disk-15ml.stl
61.0 x 48.2 x 5.90
