demircitaks/proxys/measuring-cup/stl/01-govde-15ml.stl

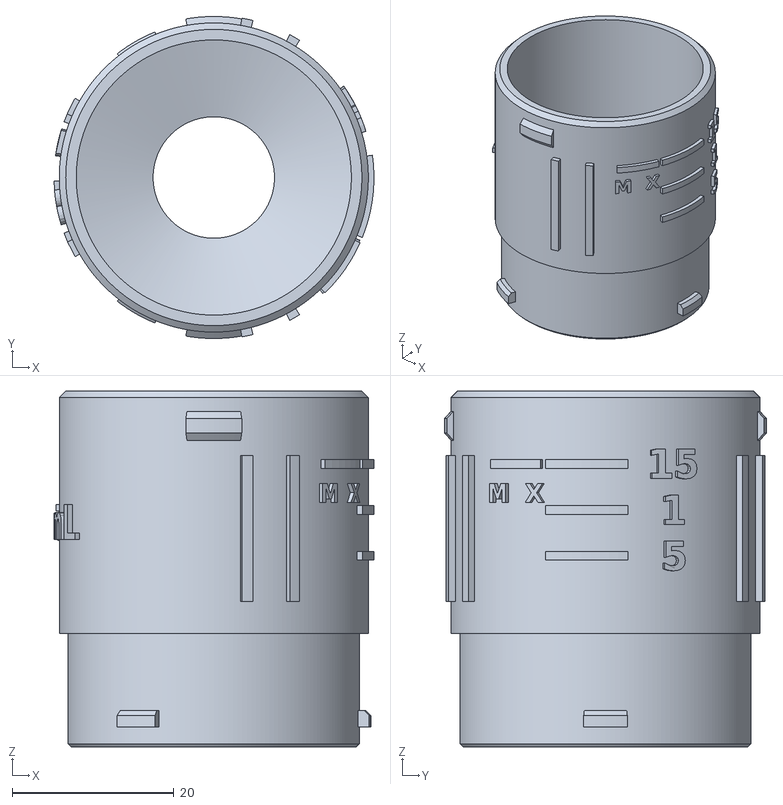
[picture p65: CAD file, 2026-09-24]
measuring-cup/stl/01-govde-15ml.stl
39.5 x 39.8 x 44.0
