demircitaks/proxys/measuring-cup/stl/toz-surgulu/04-huni-pet.stl

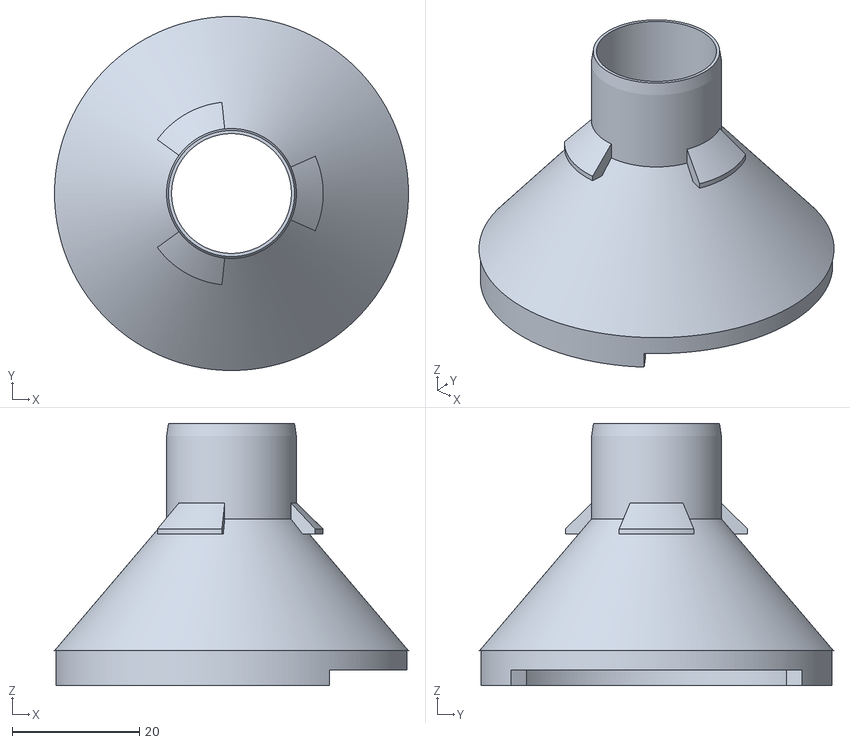
[picture p66: CAD file, 2026-09-24]
measuring-cup/stl/toz-surgulu/04-huni-pet.stl
55.6 x 55.6 x 41.2
