demircitaks/proxys/measuring-cup/stl/toz-yuvarlak/04-mil-30ml.stl

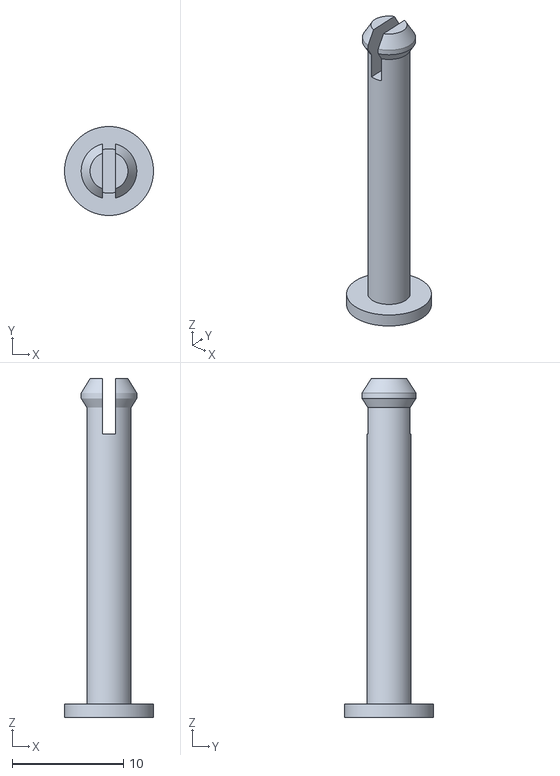
[picture p67: CAD file, 2026-09-24]
measuring-cup/stl/toz-yuvarlak/04-mil-30ml.stl
8.00 x 8.00 x 30.5
