demircitaks/proxys/measuring-cup/stl/04-kopru.stl

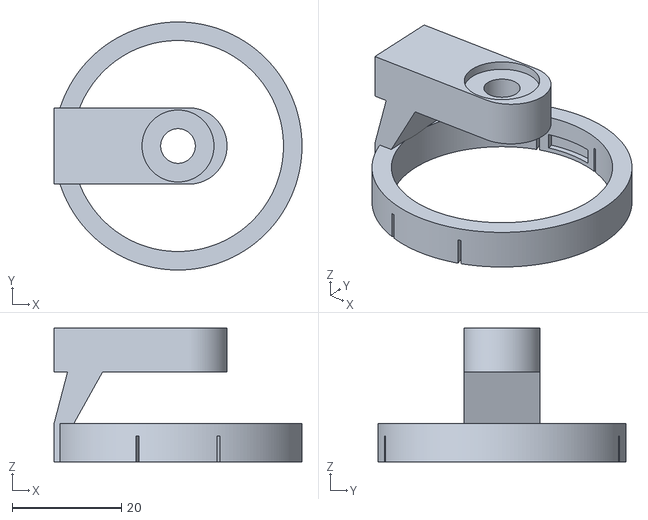
[picture p68: CAD file, 2026-09-24]
measuring-cup/stl/04-kopru.stl
45.5 x 45.5 x 24.5
