demircitaks/proxys/measuring-cup/stl/toz-yuvarlak/04-mil-15ml.stl

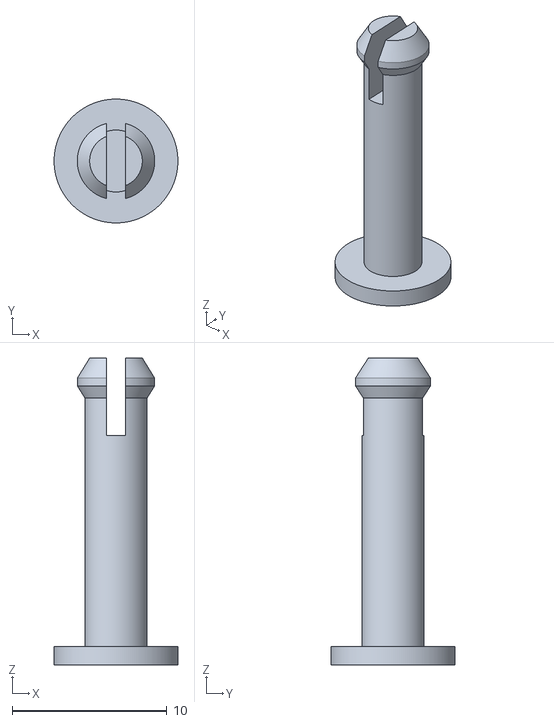
[picture p69: CAD file, 2026-09-24]
measuring-cup/stl/toz-yuvarlak/04-mil-15ml.stl
8.00 x 8.00 x 19.8
