demircitaks/proxys/(list of files, cad)

Other CAD files:
measuring-cup/stl/toz-mini/01-hazne-30ml.stl
measuring-cup/stl/toz-mini/baski/01-hazne-15ml.stl
measuring-cup/x1c/kepce-30ml-X1C.gcode.3mf
measuring-cup/stl/toz-mini/baski/03-ust-kapak-30ml.stl
measuring-cup/x1c/kepce-15ml-X1C.gcode.3mf
measuring-cup/stl/toz-mini/baski/03-ust-kapak-15ml.stl
measuring-cup/stl/toz-olcegi/01-hazne-15ml.stl
measuring-cup/stl/toz-olcegi/01-hazne-30ml.stl
measuring-cup/stl/toz-olcegi/03-sap.stl
measuring-cup/stl/toz-olcegi/04-huni-pet.stl
measuring-cup/stl/toz-sade/01-hazne-15ml.stl
measuring-cup/stl/toz-sade/01-hazne-30ml.stl
measuring-cup/stl/toz-sade/03-ust-kapak-15ml.stl
measuring-cup/stl/toz-sade/03-ust-kapak-30ml.stl
