demircitaks/proxys/measuring-cup/docs/montaj-30ml.png

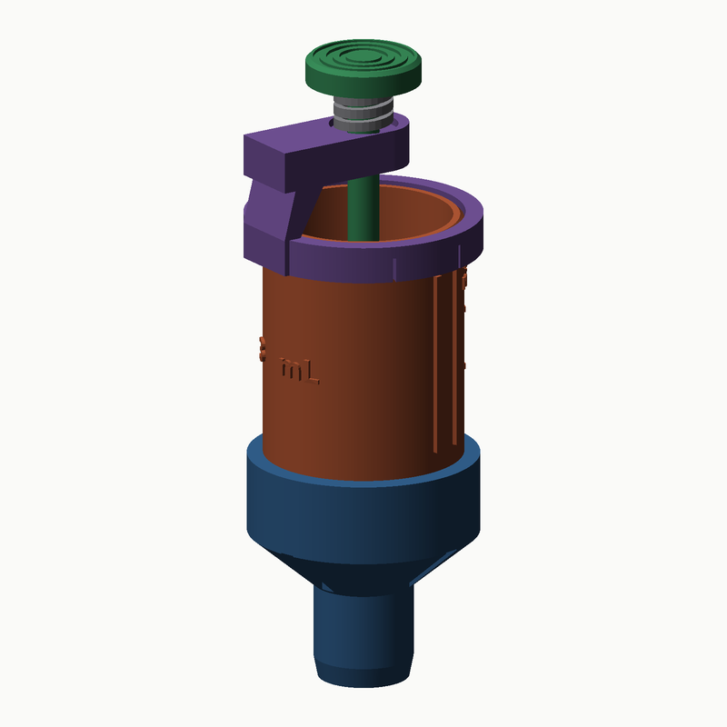
measuring-cup/docs/montaj-30ml.png
