demircitaks/proxys/measuring-cup/docs/toz-montaj-30ml-acilar.png

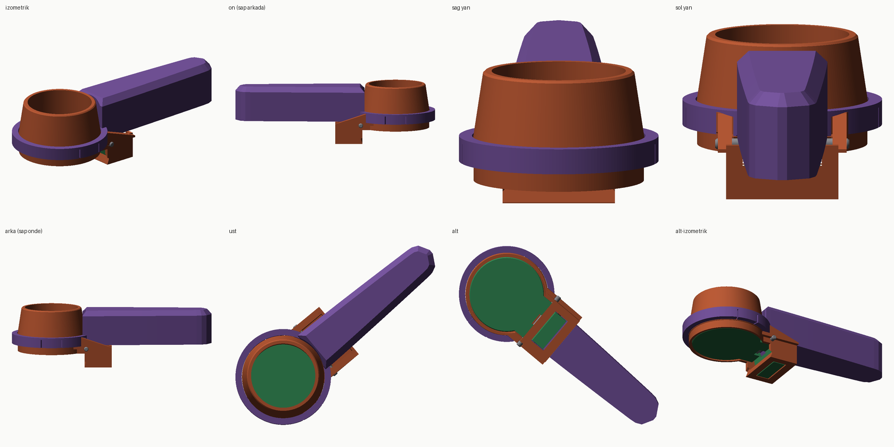
measuring-cup/docs/toz-montaj-30ml-acilar.png
