demircitaks/proxys/measuring-cup/docs/toz-montaj-acik-acilar.png

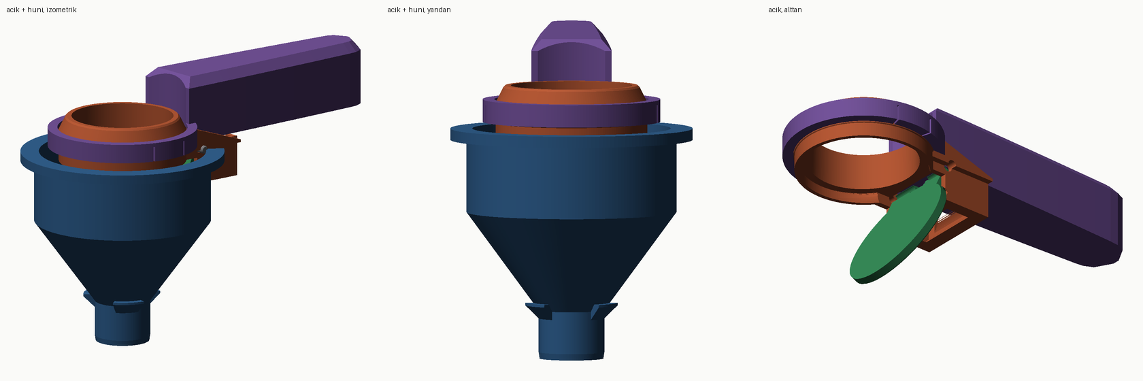
measuring-cup/docs/toz-montaj-acik-acilar.png
