demircitaks/proxys/(commit log)

2026-09-24 Add bottom-dump measuring cup (15/30 mL) for FDM printing
    Parametric design for a dosing cup whose floor opens on a thumb press,
    so the measured liquid drops straight into a PET bottle neck without a
    funnel.
    Mechanism: a central poppet with a 45-degree conical seat. The plug is
    pushed up into the seat by a spring above the rim, so liquid weight
    helps keep it shut; pressing the button lowers the plug 5 mm and opens
    about 85 mm2 of flow area. A single-arm C bridge guides the stem and
    leaves the cup mouth open for filling. The spout ring locks onto the
    body with a 3-lug bayonet and carries a 50-degree cone that centres the
    tool on a 28 mm PCO-1881 bottle neck, with four vent channels so the
    bo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
    [01-govde-15ml.stl, 01-govde-30ml.stl, 02-platform-mil-15ml.stl, 02-platform-mil-30ml.stl, 03-bosaltma-agzi.stl, 04-kopru.stl, 05-yay-baskili.stl, 06-altlik.stl]
2026-09-24 Add kinematics validator and free-form geometry helpers
    Groundwork for the powder-scoop variant, where the floor swings open
    instead of a poppet lifting.
    kinematics.py measures a moving part instead of asserting about it:
    sweep_clearance() rotates it through its travel and reports the collision
    volume with the body at each step, open_area() projects the moving part
    onto the seat plane and reports how much of the discharge bore is
    genuinely uncovered, and swept_envelope_depth() reports how far below the
    seat the part sweeps (which sets how tall the funnel under it has to be).
    Measured with it: a single full-bore leaf hinged at the bore edge is only
    51% open at 60 degrees and sweeps 47 mm be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
2026-09-24 Add powder dosing scoop (15/30 mL) with full-bore drop hatch
    The liquid design does not work for protein powder or pre-workout: the
    poppet's 1.2 mm annulus clogs, the bridge over the mouth makes it
    impossible to strike level, and the 29 mm spout underneath makes it
    impossible to dip into a tub. This is a separate tool for powder.
    The whole floor of the cup is a single hatch, hinged 2.7 mm outside the
    bore edge in the sealing plane, with its tail carried on past the hinge
    into a trigger wedge under the handle. Squeezing the wedge up swings the
    floor down and away: no annulus, no convergence, no restriction anywhere
    in the powder path, so the charge leaves as one slug. The handle is a
    separat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
    [01-hazne-15ml.stl, 01-hazne-30ml.stl, 02-kapak-tetik.stl, 03-sap.stl, 04-huni-pet.stl, 05-mentese-mili.stl]
2026-09-24 Add powder scoop cross-sections and Turkish build guide
    section_scoop.py takes its sections straight off the meshes with a y=0
    cutting plane, so the drawing cannot drift from the model.
    TOZ-OLCEGI.md documents the mechanism, the measured verification numbers,
    print settings, assembly and use, and states plainly what the design does
    not solve: volumetric repeatability is about 2% but mass is 5-15%
    whatever the geometry, a 21.7 mm PET neck is a poor route for a 30 mL
    powder dose (hence shaker for 30 mL, funnel for 15 mL), and the 71.5 mm
    funnel is the direct cost of a single full-bore hatch sweeping 42.5 mm.
    Claude-Session: https://claude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
2026-09-24 Enclose the scoop mechanism so the underside is closed and flat
    Dipping the previous body into a tub would have packed powder into
    every downward-facing cavity: the 3 mm step around the hatch, the open
    hinge cheeks, the trigger wedge, and the spring pocket and trigger slot
    under the handle. Lifting it out would have shed powder from all of them.
    The hinge, tail and spring now live in a closed box on the back of the
    body. The tail's flat underside sits flush in an opening in the box floor
    as a recessed button, and a skirt around the hatch brings the flange down
    to the hatch's own bottom face. What touches powder is now two flat
    planes with 0.5 mm ring gaps, both open downward so anything tha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
    [01-hazne-15ml.stl, 01-hazne-30ml.stl, 02-kapak-tetik.stl, 03-sap.stl]
2026-09-24 Show both scoop chambers side by side in the guide
    Claude-Session: https://claude.ai/code/session_018x3qUpRg2NWHwAu9z62qwN
2026-09-24 Add multi-angle assembly renders for both scoop sizes
    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
2026-09-24 Add sliding-plate scoop variant with a closed, flat underside
    The user pointed at a commercial dose scoop: a closed cup, a hole in the
    floor, one plate over it, a thumb lever along the handle. Nothing hangs
    below. The hinged full-floor hatch could not give that, because a hatch
    that swings down needs a housing and a sweep envelope under the cup.
    Here the plate is the floor itself. It rides in two C-channels under the
    cup's flange and slides 26 mm toward the handle, driven by a stirrup
    that straddles the handle neck and is pushed with the thumb. The channel
    lips ramp up 0.35 mm over the last 7 mm so the plate wedges against the
    sealing land when closed; there is no spring and no pin. The cup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
    [01-hazne-15ml.stl, 01-hazne-30ml.stl, 02-surgu.stl, 03-sap.stl, 04-huni-pet.stl]
2026-09-24 Turn the sliding scoop into a portable dose container
    The user's use is fill at home, close, carry in a bag, screw onto a PET
    bottle at the gym, slide open. That needs a lid and a positive fit to the
    bottle, neither of which the loose funnel collar gave.
    - Snap-on top lid per size: a bead 3 mm under the rim, a V-groove in the
    lid skirt with four flex slits, and a 1.8 mm plug ring that enters the
    bore so the closed container is powder-tight at both ends (the plate
    is wedge-locked at the bottom).
    - The funnel now screws onto the bottle: a PCO-1881/1810 cap section
    with a 2.7 mm pitch, 1.6-turn internal thread with 45-degree flanks
    (prints support-free like any printed bottle cap), t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
    [01-hazne-15ml.stl, 01-hazne-30ml.stl, 03-sap.stl, 04-huni-pet-vidali.stl, 05-ust-kapak-15ml.stl, 05-ust-kapak-30ml.stl]
2026-09-24 Seal the sliding container: O-ring in the land, wider plate, 34 mm travel
    Three leak paths, each closed:
    - In the bag, past the plate's edge. The plate overlapped the sealing
    land by only 0.4 mm at the sides. The plate is now 42 mm wide and the
    land carries a groove for a standard 38 x 1.5 O-ring; the channel-lip
    wedge (now 0.5 mm over the last 8 mm) presses the plate onto it by
    0.45 mm. A TPU gasket is exported for anyone without an O-ring.
    - The film dragged out on the plate during retraction. The O-ring's rear
    arc now wipes the plate as it slides, instead of a 0.3 mm clearance.
    - Powder left on the strip the plate never uncovered. 26 mm of travel
    opened 79% of the bore and le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
    [01-hazne-15ml.stl, 01-hazne-30ml.stl, 02-surgu.stl, 04-huni-pet-vidali.stl, 06-conta-tpu.stl]
2026-09-24 Add the slim double-slide scoop
    The user wanted an ordinary scoop, not a container kit: a cup, a thin
    handle, a sliding cover on the bottom and one on the top, and a small
    detent so neither slides open in a bag. This variant is that.
    The bottom plate is the one from the sliding container (C-channels,
    O-ring, wedge, 34 mm travel, 92% open). The top lid rides in two C-rails
    at the rim with its underside exactly in the rim plane, so closing it
    sweeps the excess powder off: the lid is the strike, and the dose is
    the brim volume under it. Both lids carry an edge notch that clicks over
    a 0.45 mm bump in the rail. The handle is a one-piece 12 x 8 hexagonal
    bar; a 0.8 mm break-away strut under it l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
    [01-hazne-15ml.stl, 01-hazne-30ml.stl, 02-alt-plaka.stl, 03-ust-kapak-15ml.stl, 03-ust-kapak-30ml.stl, 04-huni-pet-vidali.stl, 05-conta-tpu.stl]
2026-09-24 Yuvarlak kepce: pivotlu disk kapaklar, teget kilit + centik
    Kare gorunen sade varyantin yerine yuvarlak hazneli surum: alt ve ust
    kapak, sapin kokundeki tek mile takili yuvarlak diskler; kapanmanin son
    14 derecesinde tirnaklar on tuneldeki kamaya girer ve 0,35 mm centik
    tumsegi O-ring esnekligiyle klik yapar. Huni bileziği on kilit yuvasi
    ve tirnagin buyutulmus supurme hacmiyle oyuldu (girisim 0).
    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
    [01-hazne-15ml.stl, 01-hazne-30ml.stl, 02-alt-disk.stl, 03-ust-disk-15ml.stl, 03-ust-disk-30ml.stl, 04-mil-15ml.stl, 04-mil-30ml.stl, 05-huni-pet-vidali.stl]
2026-09-24 Yuvarlak kepce: alti pet siseye giren tek parca huni
    Ayri vidali huni kaldirildi; haznenin altina 45 derecelik koni ve
    Ø20,8 x 7 mm boru (PCO-1881) eklendi. Alt disk huni halkasi ile flans
    arasindaki yariktan yana kayar; huni govdeye +y tarafindaki kanatla
    bagli. Sap agiz duzlemine alindi ve hazne ters (agiz tablada) basilir:
    cikinti %9,4 -> %3,1, tamami kopru. Donus supurmeleri yeniden dogrulandi.
    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
    [01-hazne-15ml.stl, 01-hazne-30ml.stl, 05-conta-tpu.stl, 05-huni-pet-vidali.stl]
2026-09-25 Yuvarlak kepce: gercek mandal (tirnak + yay parmagi + tumsek, burun)
    Eski tunel/tumsek kilidi diski O-ring'e bastirmiyor ve centik yalniz
    diskin egilmesine dayaniyordu. Yerine: govdenin onunde pivot merkezli
    bir burun; alt diskin tirnagi rampali C-kanala girip diski O-ring'e
    iter, ust kapagin bacak+ayagi dudagin altina girip kapagi agza ceker.
    Her tirnagin yaninda 10 mm teget yay parmagi ve 0,6 mm tumsek: kapali
    konumda kanal duvarindaki yuvaya oturur (klik), acarken 0,45 mm esner.
    Mandal geometrisi pivot yaylari (kanal duvari ile parmak arasi sabit).
    Dogrulama: tumseksiz donus girisimi 0, tumsek ilk 10 derecede 1,7-2,1 mm3.
    Claude-S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
    [01-hazne-15ml.stl, 01-hazne-30ml.stl, 02-alt-disk.stl, 03-ust-disk-15ml.stl, 03-ust-disk-30ml.stl, 05-conta-tpu.stl]
2026-09-25 Yuvarlak kepce: tabani sapa dogru kayan plaka (tek elle)
    Pivotlu alt disk yerine 42 mm kayan taban plakasi: sapin kokundeki iki
    yan etek (ters baskida tabladan yukselir) ve altlarindaki 45 derecelik
    dudaklar plakanin pahli kenarlarini tasir; O-ring plakayi dudaklara
    bastirir (conta kenar boyunca esit). Eteklere kesilmis dikey yay
    parmaklari plakanin kenarindaki centiklere kapali ve acik konumda oturur
    (klik). Sapin yanindaki iki cikinti basparmakla itilir. Ust kapak 120
    dereceye kadar doner (eteklere carpmadan); mil basi govde altindaki
    havsada, plaka mili tutar. Kanat kaldirildi; burun yalniz kapak icin.
    Dogrulama: plaka kaymasi ve kapak donusu girisimsiz, tumsekler yalniz
    esneme bolges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
    [01-hazne-15ml.stl, 01-hazne-30ml.stl, 02-alt-disk.stl, 02-alt-plaka-15ml.stl, 02-alt-plaka-30ml.stl]
2026-09-25 Yuvarlak kepce: alcak raylar + tetik, PDF baski kilavuzu
    Tam boy etekler ve sapin yanindaki itme cikintilari kaldirildi. Raylar
    6,5 mm yuksek (dudak + kisa dis duvar), iki ince kopruyle sapa bagli;
    ters baskida ray ust kenari 19/22 mm koprulenir. Plakanin altinda,
    sapin kokunun altinda tirtikli tetik cubugu: isaret parmagi ceker
    (acar) / iter (kapar). Kilit: plakanin kenarina kesilmis yay parmaklari
    rayin ic yuzundeki yuvalara kapali ve acik konumda oturur. Plaka iki
    boy icin ortak, conta yuzu tablada basilir. cad/print_doc.py ile
    BASKI-KILAVUZU.pdf (parcalar, yonler, X1C ayarlari, montaj, ince ayar).
    Claude-Session: https://clau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
    [01-hazne-15ml.stl, 01-hazne-30ml.stl, 02-alt-plaka-15ml.stl, 02-alt-plaka-30ml.stl, 02-alt-plaka.stl]
2026-09-27 Mini kepce: 3 parca, donen taban kapagi, destek yok
    Basit surum: yuvarlak hazne (tabaninda kenara yakin Ø22 delik, kisa
    sap), altina klik diye gecen 3 mm doner taban kapagi (ayni delik +
    sise boynu oturma cukuru, 180 derecede acik/kapali, iki centik) ve
    agza klik yapan ust kapak. Pim, O-ring, ray yok; her parca duz yuzu
    tablada desteksiz basilir. cad/scoop_mini.py, cad/build_mini.py,
    stl/toz-mini/, TOZ-MINI.md; BASKI-KILAVUZU.pdf bu surum icin yenilendi.
    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
    [01-hazne-15ml.stl, 01-hazne-30ml.stl, 02-taban-kapagi.stl, 03-ust-kapak-15ml.stl, 03-ust-kapak-30ml.stl]
2026-09-27 Mini kepce: deliksiz surgu plakasi, sapin ustunden basparmakla cekilir
    Donen delikli taban kapagi yerine haznenin taban levhasi icindeki
    kanalda kayan deliksiz plaka: kolu sapin icinden gecer, sapin ustunde
    tirtikli basparmak surgusu olarak cikar. 24 mm kendine cekince delik
    acilir; kapaliyken plaka deligi tamamen orter (cantada dokulmez).
    Yay parmaklari kanal duvarindaki yuvalara iki konumda oturur. Alt
    delik 45 derece havsali (sise agzi ortalanir). Belgeler ve PDF guncel.
    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
    [01-hazne-15ml.stl, 01-hazne-30ml.stl, 02-surgu.stl, 02-taban-kapagi.stl, 03-ust-kapak-15ml.stl, 03-ust-kapak-30ml.stl]
2026-09-27 Mini kepce: huni tabanli hazne, aciklik tabanin tamami
    Duz taban + kaydirilmis delik yerine: hazne altta 45 derecelik huniyle
    Ø22 acikliga daralir (aciklik = tabanin tamami), disi altta 45 derece
    pahli. Derinlik yeniden kalibre (15 mL 15,7 mm, 30 mL 26,9 mm; ic
    hacim 14,997 / 29,992 mL). Surgu kanali haznenin altindaki ince taban
    levhasinda, levha sapin kokune uzanir; surgu 29 mm. Kesit gorseli eklendi.
    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
    [01-hazne-15ml.stl, 01-hazne-30ml.stl, 02-surgu.stl, 03-ust-kapak-15ml.stl, 03-ust-kapak-30ml.stl]
2026-09-27 Mini kepce: sap agiz hizasinda, surgu ayakli
    Sap tabandan agiz hizasina alindi (cidara bagli, kokunde catal yarigi);
    hazne artik agiz tablada (ters) basilir, huni ve pah 45 derece oldugu
    icin destek yok. Surgunun kolu haznenin disinda dik bir ayakla sapin
    seviyesine yukselir, catalin icinden gecer, ustte basparmak surgusu;
    ayak boyu hazneye gore (15/30 ayri). Taban levhasi yalniz daire; acik
    konum ayagin catala dayanmasiyla, kapali konum yay parmagi klikiyle.
    Ust kapagin etegi sap hizasinda kesik. Belgeler, kesit ve PDF guncel.
    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
    [01-hazne-15ml.stl, 01-hazne-30ml.stl, 02-surgu-15ml.stl, 02-surgu-30ml.stl, 02-surgu.stl, 03-ust-kapak-15ml.stl, 03-ust-kapak-30ml.stl]
2026-09-27 Mini kepce: STL'ler model yonunde, baski yonu ayri klasorde
    Hazne ve kapak STL'leri artik kullanildigi gibi (sap ustte) kaydedilir;
    baski icin cevrilmis kopyalar stl/toz-mini/baski/ altinda. Belgelerde
    "180 derece cevir" notu.
    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
    [01-hazne-15ml.stl, 01-hazne-30ml.stl, 02-surgu-15ml.stl, 02-surgu-30ml.stl, 03-ust-kapak-15ml.stl, 03-ust-kapak-30ml.stl]
2026-09-27 Mini kepce: sise boynuna giren boru
    Acikligin altina 45 derece koniyle daralan Ø20,6 x 8 mm boru eklendi
    (ic Ø18,4): 500 mL pet su sisesi boynuna (PCO-1881 ic Ø21,74) 0,57 mm
    boslukla girer, toz disari dokulmez. Alt deri 1,8 mm. Ters baskida
    boru en ustte, dik cikinti yok. Kesitte sise boynu semasi.
    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
    [01-hazne-15ml.stl, 01-hazne-30ml.stl, 02-surgu-30ml.stl, 03-ust-kapak-15ml.stl, 03-ust-kapak-30ml.stl]
2026-10-03 Mini kepce: X1C icin dilimlenmis .gcode.3mf ve proje 3MF'leri
    OrcaSlicer 2.3 CLI ile Bambu X1C 0.4 nozul / 0.16 mm / Bambu PETG HF
    profilleriyle dilimlendi (3 duvar, %15 gyroid, destek yok, brim yok,
    Textured PEI 70 C). x1c/: kepce-15ml-X1C.gcode.3mf (57 dk, 21,5 g),
    kepce-30ml-X1C.gcode.3mf (70 dk, 26,8 g), dilimlenmemis proje 3MF'ler,
    duzlestirilmis profiller; cad/slice_x1c.sh + cad/postprocess_3mf.py
    (onizleme PNG, BL-P001 model kimligi). Taban levhasi r 19 (kanal on
    duvari 1,85 mm) ve arkasi kanal genisliginde kesik: dilimleyicinin
    "floating cantilever" uyarisi kalkti. Gorseller, kesit, PDF guncel.
    Claude-Session: https://claud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
    [01-hazne-15ml.stl, 01-hazne-30ml.stl, kepce-15ml-X1C.gcode.3mf, kepce-15ml-proje.3mf, kepce-30ml-X1C.gcode.3mf, kepce-30ml-proje.3mf, machine.json]
